prusa3d/Buddy-board-MINI-PCB/rev.1.0.0/shapes3D/W25Q64FVSSIG.stp

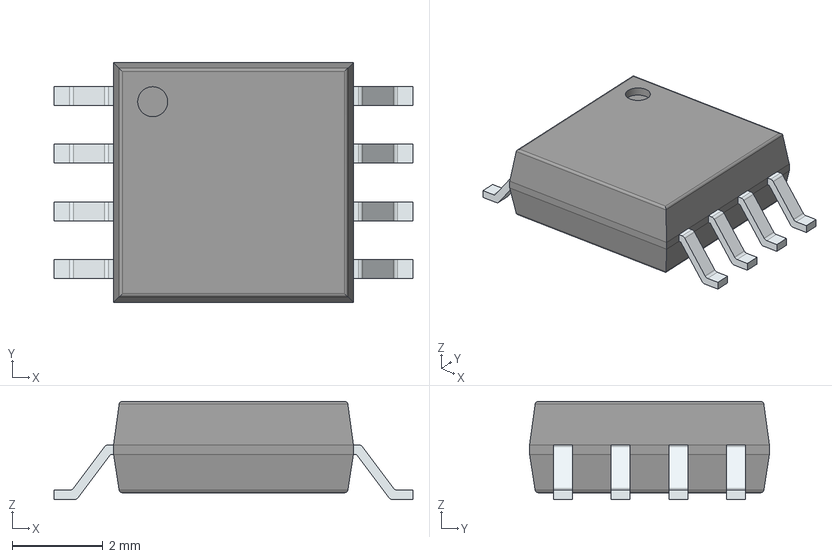
[picture p2: CAD file, 2019-12-11]
rev.1.0.0/shapes3D/W25Q64FVSSIG.stp
7.90 x 5.28 x 2.16 mm
PinsArrayLR
