prusa3d/Buddy-board-MINI-PCB/rev.1.0.0/shapes3D/DT1140-04LP.step

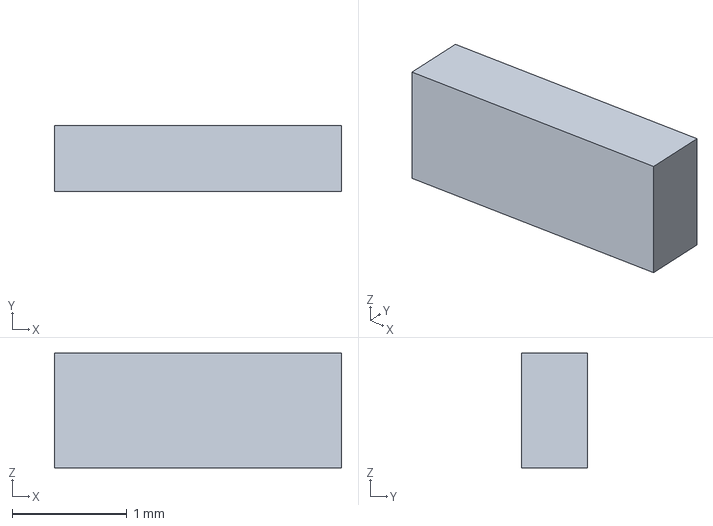
[picture p3: CAD file, 2019-12-11]
rev.1.0.0/shapes3D/DT1140-04LP.step
2.50 x 0.575 x 1.00 mm
