prusa3d/Buddy-board-MINI-PCB/rev.1.0.0/shapes3D/RJMG163118101NR.step

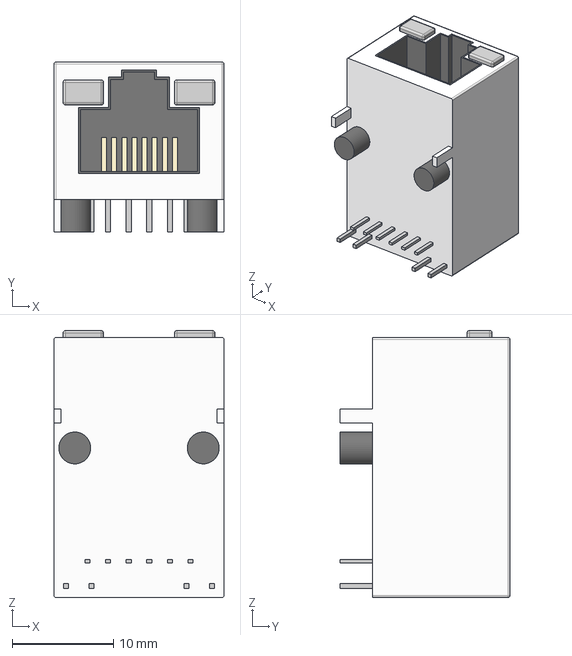
[picture p4: CAD file, 2019-12-11]
rev.1.0.0/shapes3D/RJMG163118101NR.step
16.8 x 16.8 x 26.4 mm
