prusa3d/Buddy-board-MINI-PCB/rev.1.0.0/shapes3D/Ethernet_HR911105A v1.step

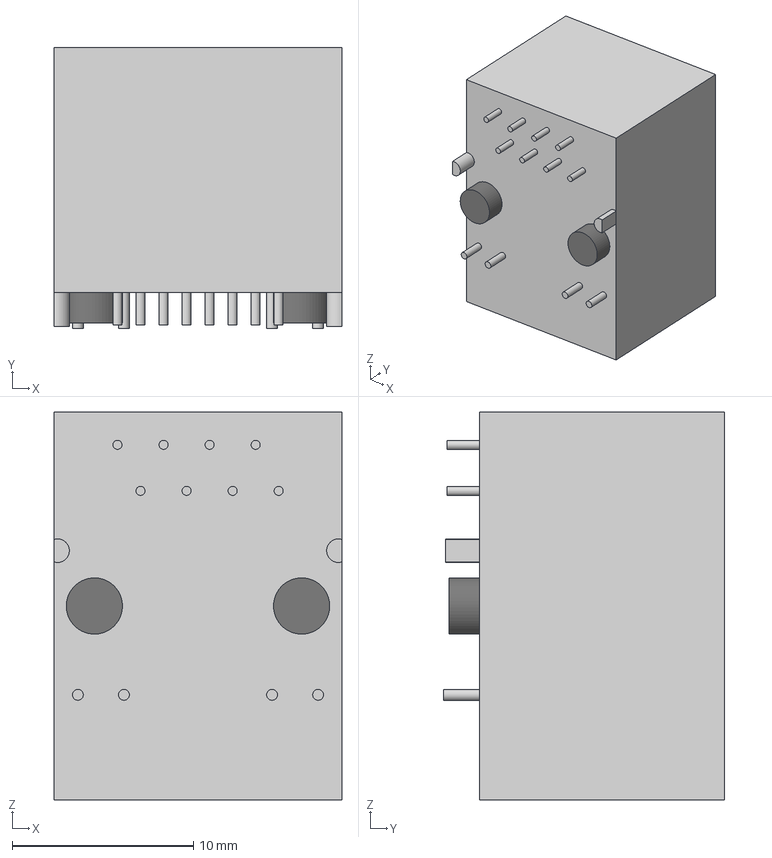
[picture p5: CAD file, 2019-12-11]
rev.1.0.0/shapes3D/Ethernet_HR911105A v1.step
15.9 x 15.5 x 21.4 mm
