prusa3d/Buddy-board-MINI-PCB/rev.1.0.0/shapes3D/559321010.stp

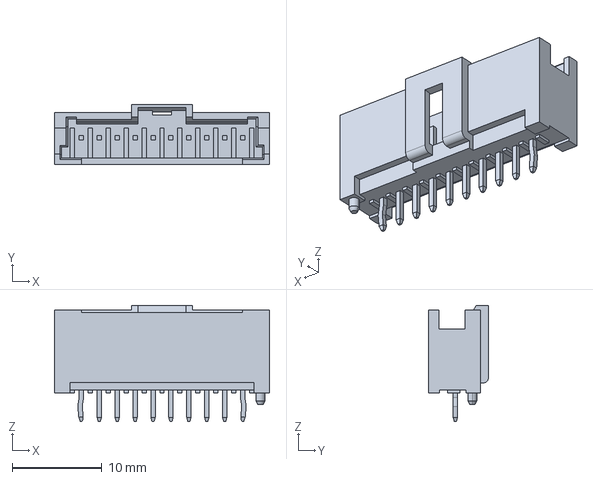
[picture p6: CAD file, 2019-12-11]
rev.1.0.0/shapes3D/559321010.stp
24.0 x 6.70 x 12.9 mm
