prusa3d/Buddy-board-MINI-PCB/rev.1.0.0/shapes3D/5031591200.stp

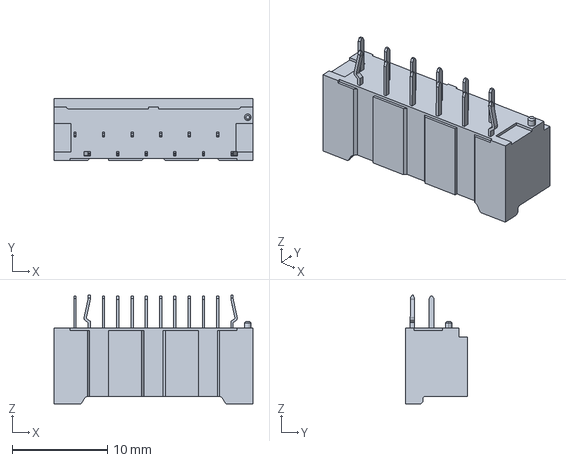
[picture p7: CAD file, 2019-12-11]
rev.1.0.0/shapes3D/5031591200.stp
20.9 x 6.55 x 11.4 mm
