prusa3d/Buddy-board-MINI-PCB/rev.1.0.0/shapes3D/7499010121A (rev1).stp

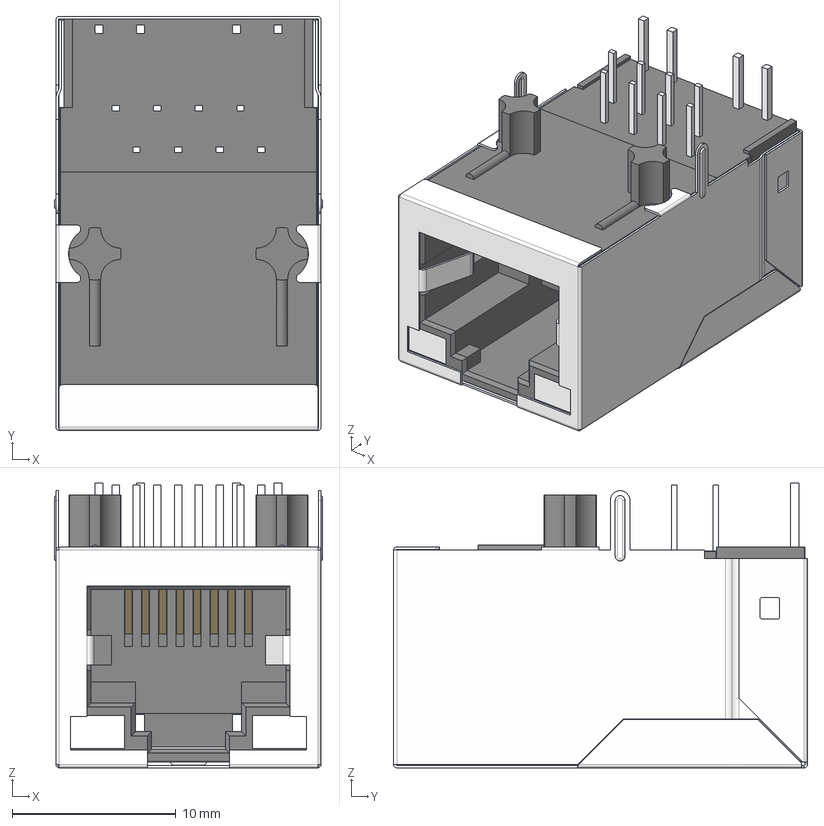
[picture p8: CAD file, 2019-12-11]
rev.1.0.0/shapes3D/7499010121A (rev1).stp
16.4 x 25.3 x 17.4 mm
Insulator
Insulator_2
Shielding
LED x 2
