prusa3d/Buddy-board-MINI-PCB/rev.1.0.0/shapes3D/673298020.stp

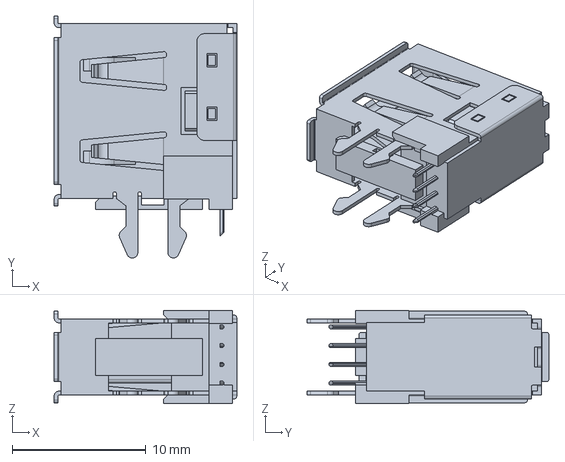
[picture p9: CAD file, 2019-12-11]
rev.1.0.0/shapes3D/673298020.stp
13.7 x 18.1 x 7.00 mm
