prusa3d/Buddy-board-MINI-PCB/rev.1.0.0/shapes3D/934635206.stp

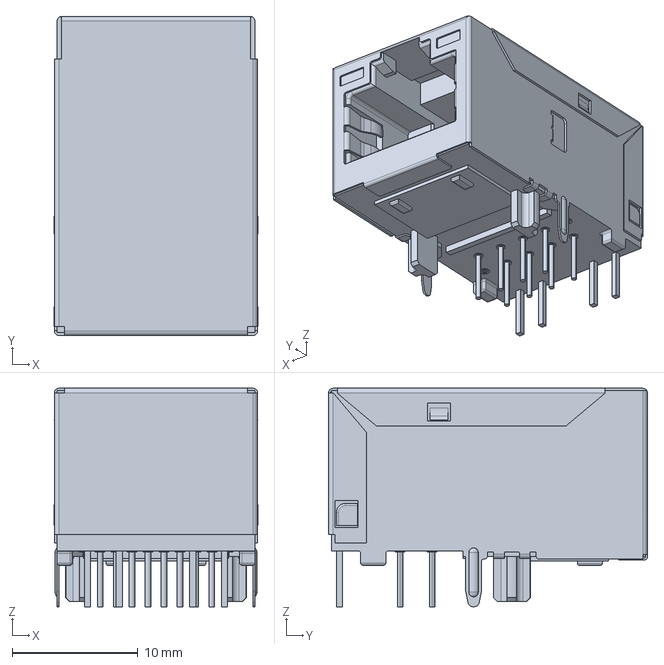
[picture p10: CAD file, 2019-12-11]
rev.1.0.0/shapes3D/934635206.stp
16.2 x 25.4 x 17.4 mm
