prusa3d/Buddy-board-MINI-PCB/(list of files, cad)

Other CAD files:
rev.1.0.0/shapes3D/673298000.stp
