prusa3d/Buddy-board-MINI-PCB/(threads)

Thread 1 (2019-12-11):

Wrong link to Interactive BOM

dronecz, 2019-12-11:
Right one is: http://htmlpreview.github.io/?https://github.com/prusa3d/Buddy-board-MINI-PCB/blob/master/rev.1.0.0/ibom.html

jarodan, 2019-12-11:
Link has been fixed. Thank you

Closed 2019-12-11.

Thread 2 (2019-12-14):

Bootloader, Firmware and Compiling instructions

CacikeOtoao, 2019-12-14:
Could you point me as to where the Bootloader, Firmware and compiling instructions are for this board. Is not in the main branch of Prusa Firmwares.

3d-gussner, 2019-12-20:
Checkout https://github.com/prusa3d/Marlin/tree/buddy not sure that is all. Just found it.

CacikeOtoao, 2019-12-23:
Thanks@3d-gussner! I'm building my Buddy board from source files and still have a doubt regarding the Bootloader. Would I be able to just flash the Firmware .bbf file to the built board and not need to flash the bootloader before hand?

Thread 4 (2023-02-28):

Fan schematic appears to be wrong

your-friend-alice, 2023-02-28:
The schematic shows that the fans are controlled by low-side switching (Pin 2 always connected to +5V, Pin 1 connected to GND through an N-channel MOSFET), but probing my board I can clearly tell that the fans are being high-side switched; pin 1 remains grounded continuously while pin 2 changes state based on M106 commands. What's up with this? Is there a newer unpublished revision of the Buddy board?

Thread 5 (2023-05-04):

v1.0.5 board schematic and kicad?

andypiper, 2023-05-04:
There are revisions of the Buddy board for the MINI+ beyond v1.0.0 - are these also available in an Open Source format?
