prusa3d/Buddy-board-MINI-PCB/rev.1.0.0/BUDDY_v1.0.0.pdf

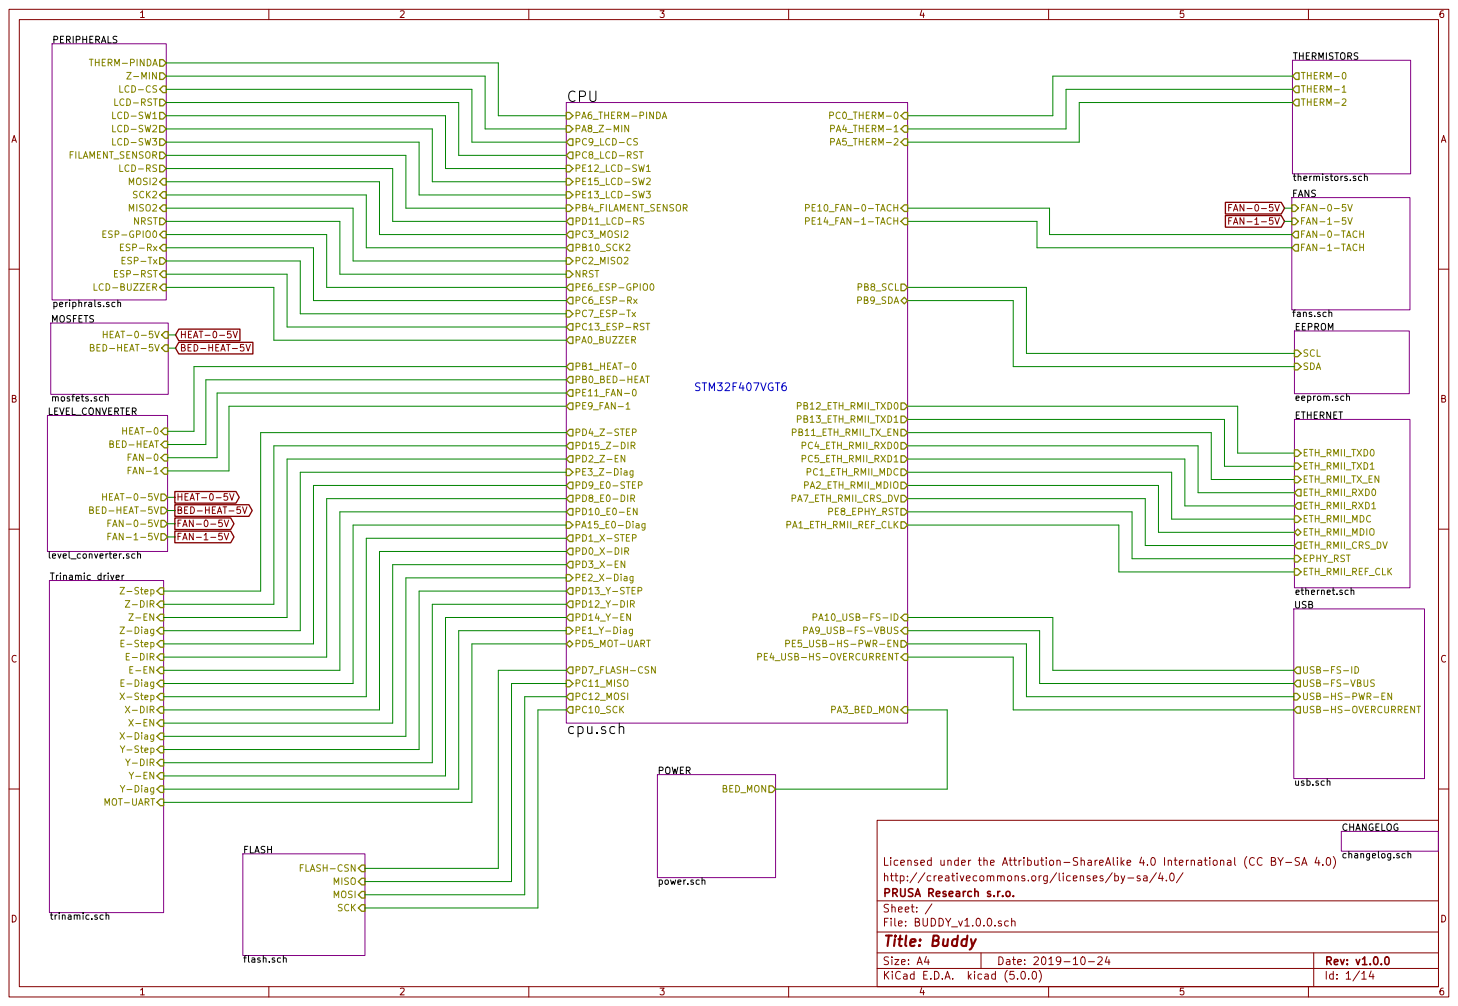
[picture p11: page 1]

periphrals.sch THERM-PINDA

Z-MIN
LCD-CS
LCD-RST
LCD-SW1
LCD-SW2
LCD-SW3
SCK2 MOSI2 NRST MISO2 ESP-Rx ESP-Tx ESP-RST ESP-GPIO0

thermistors.sch THERM-0 THERM-1 THERM-2 BED-HEAT-5V HEAT-0-5V HEAT-0-5V

USB-HS-OVERCURRENT CPU
PE11_FAN-0 PE9_FAN-1 PA8_Z-MIN
PC9_LCD-CS
PE12_LCD-SW1 PD11_LCD-RS
PC6_ESP-Rx PC7_ESP-Tx PE6_ESP-GPIO0 PD1_X-STEP
PB0_BED-HEAT PB1_HEAT-0 PD5_MOT-UART PD15_Z-DIR

eeprom.sch SCL SDA

LEVEL_CONVERTER
level_converter.schHEAT-0 FAN-0 FAN-1 BED-HEAT HEAT-0-5V

Trinamic driver
Z-Diag MOT-UART E-Step E-DIR

PE4_USB-HS-OVERCURRENT PE5_USB-HS-PWR-EN

usb.sch USB-FS-ID
USB-FS-VBUS USB-HS-PWR-EN

Licensed under the Attribution-ShareAlike 4.0 International (CC BY-SA 4.0)
File: BUDDY_v1.0.0.sch Sheet: / PRUSA Research s.r.o. http://creativecommons.org/licenses/by-sa/4.0/

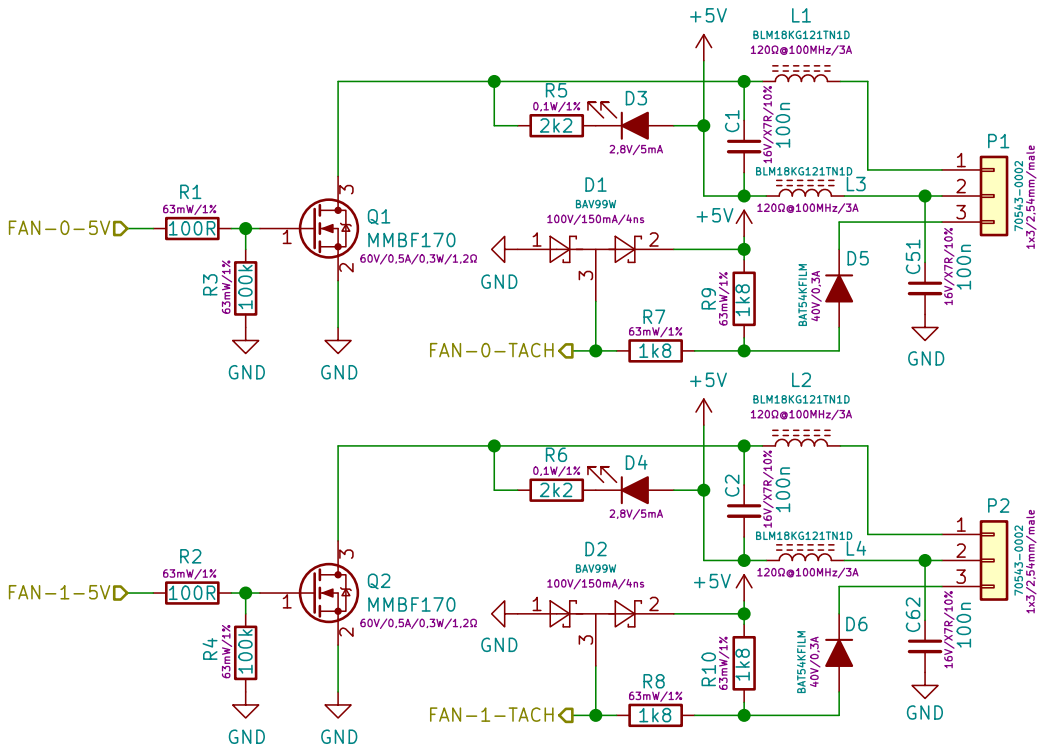
[picture p12: page 2]

Licensed under the Attribution-ShareAlike 4.0 International (CC BY-SA 4.0)
File: fans.sch Sheet: /FANS/ PRUSA Research s.r.o. http://creativecommons.org/licenses/by-sa/4.0/

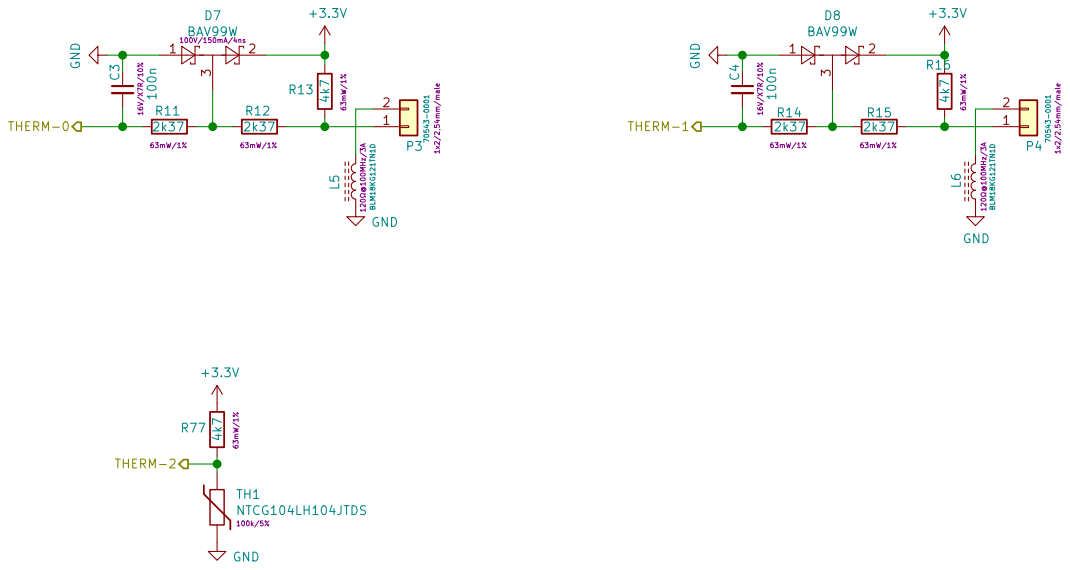
[picture p13: page 3]

Licensed under the Attribution-ShareAlike 4.0 International (CC BY-SA 4.0)
File: thermistors.sch Sheet: /THERMISTORS/ PRUSA Research s.r.o. http://creativecommons.org/licenses/by-sa/4.0/

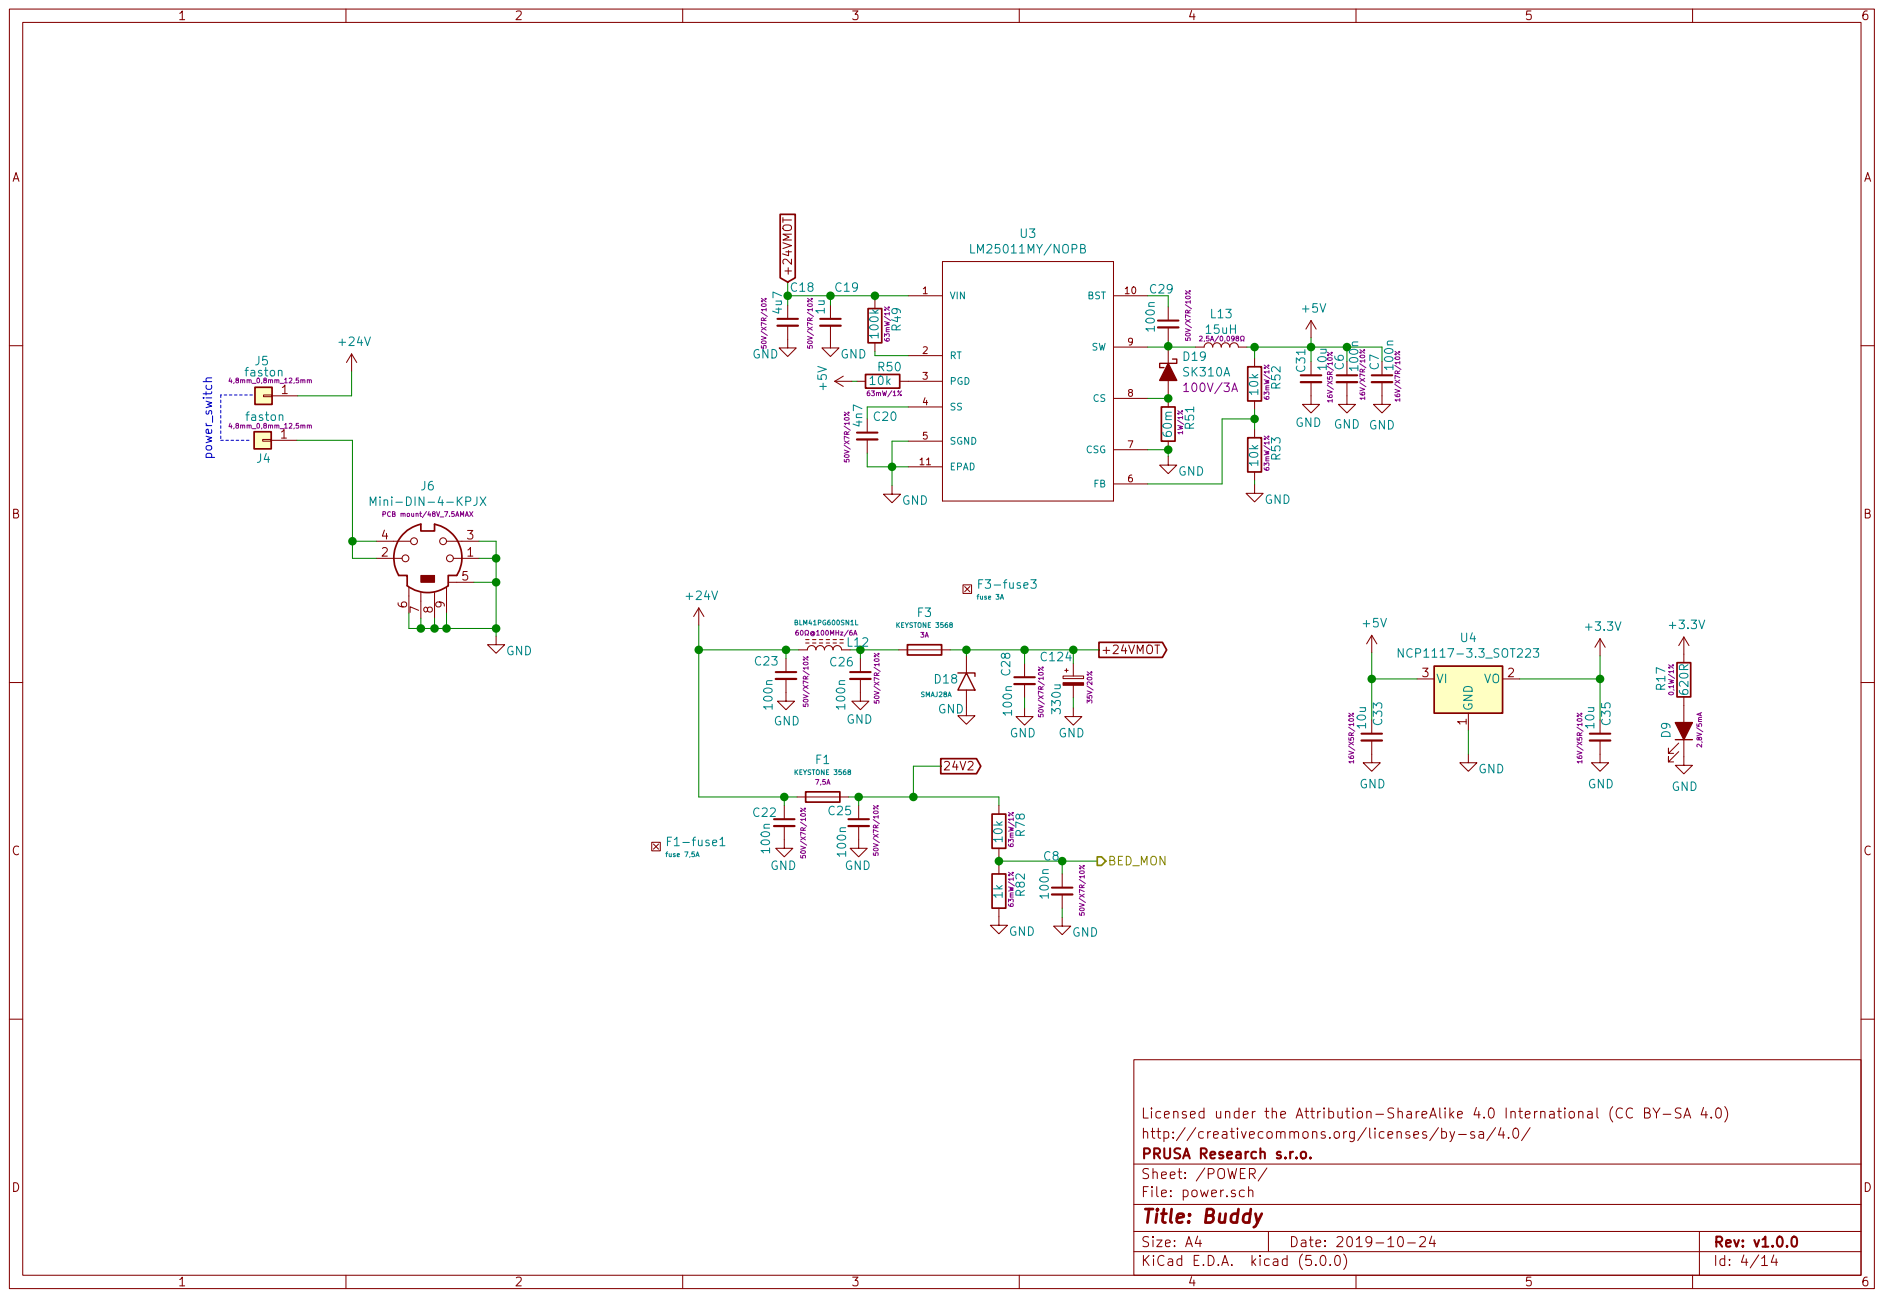
[picture p14: page 4]

Licensed under the Attribution-ShareAlike 4.0 International (CC BY-SA 4.0)
File: power.sch Sheet: /POWER/ PRUSA Research s.r.o. http://creativecommons.org/licenses/by-sa/4.0/

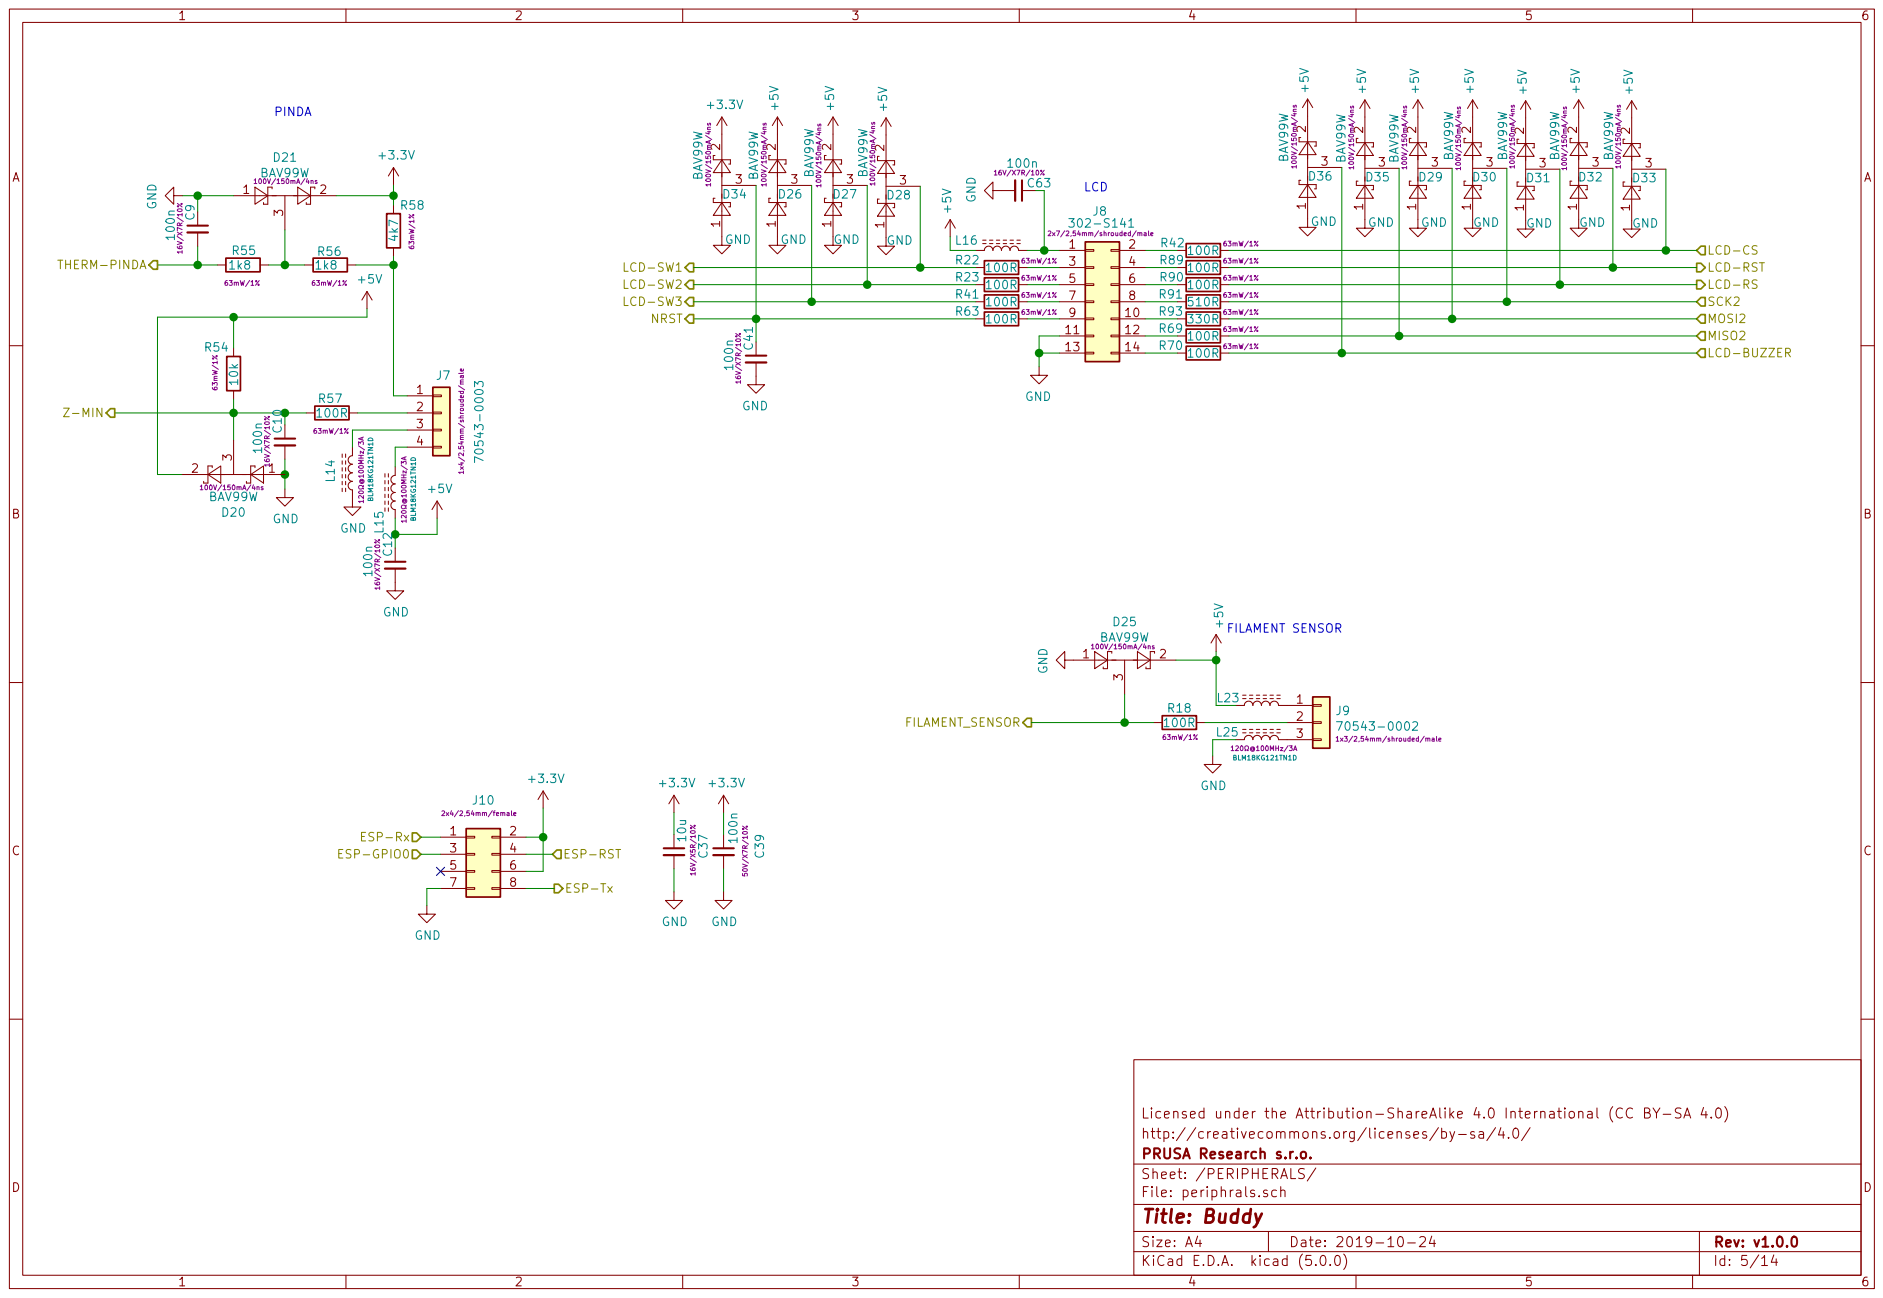
[picture p15: page 5]

Licensed under the Attribution-ShareAlike 4.0 International (CC BY-SA 4.0)
File: periphrals.sch Sheet: /PERIPHERALS/ PRUSA Research s.r.o. http://creativecommons.org/licenses/by-sa/4.0/

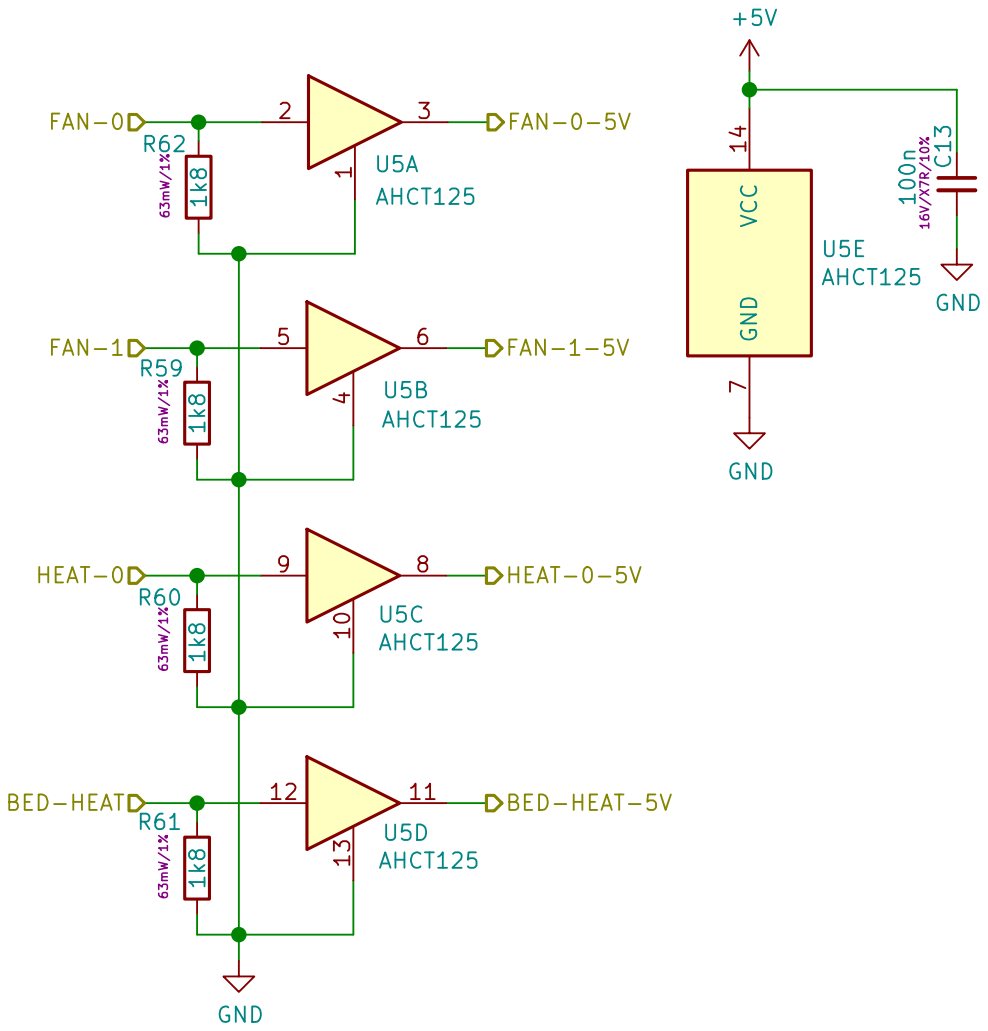
[picture p16: page 6]

Licensed under the Attribution-ShareAlike 4.0 International (CC BY-SA 4.0)
Sheet: /LEVEL_CONVERTER/ PRUSA Research s.r.o. http://creativecommons.org/licenses/by-sa/4.0/

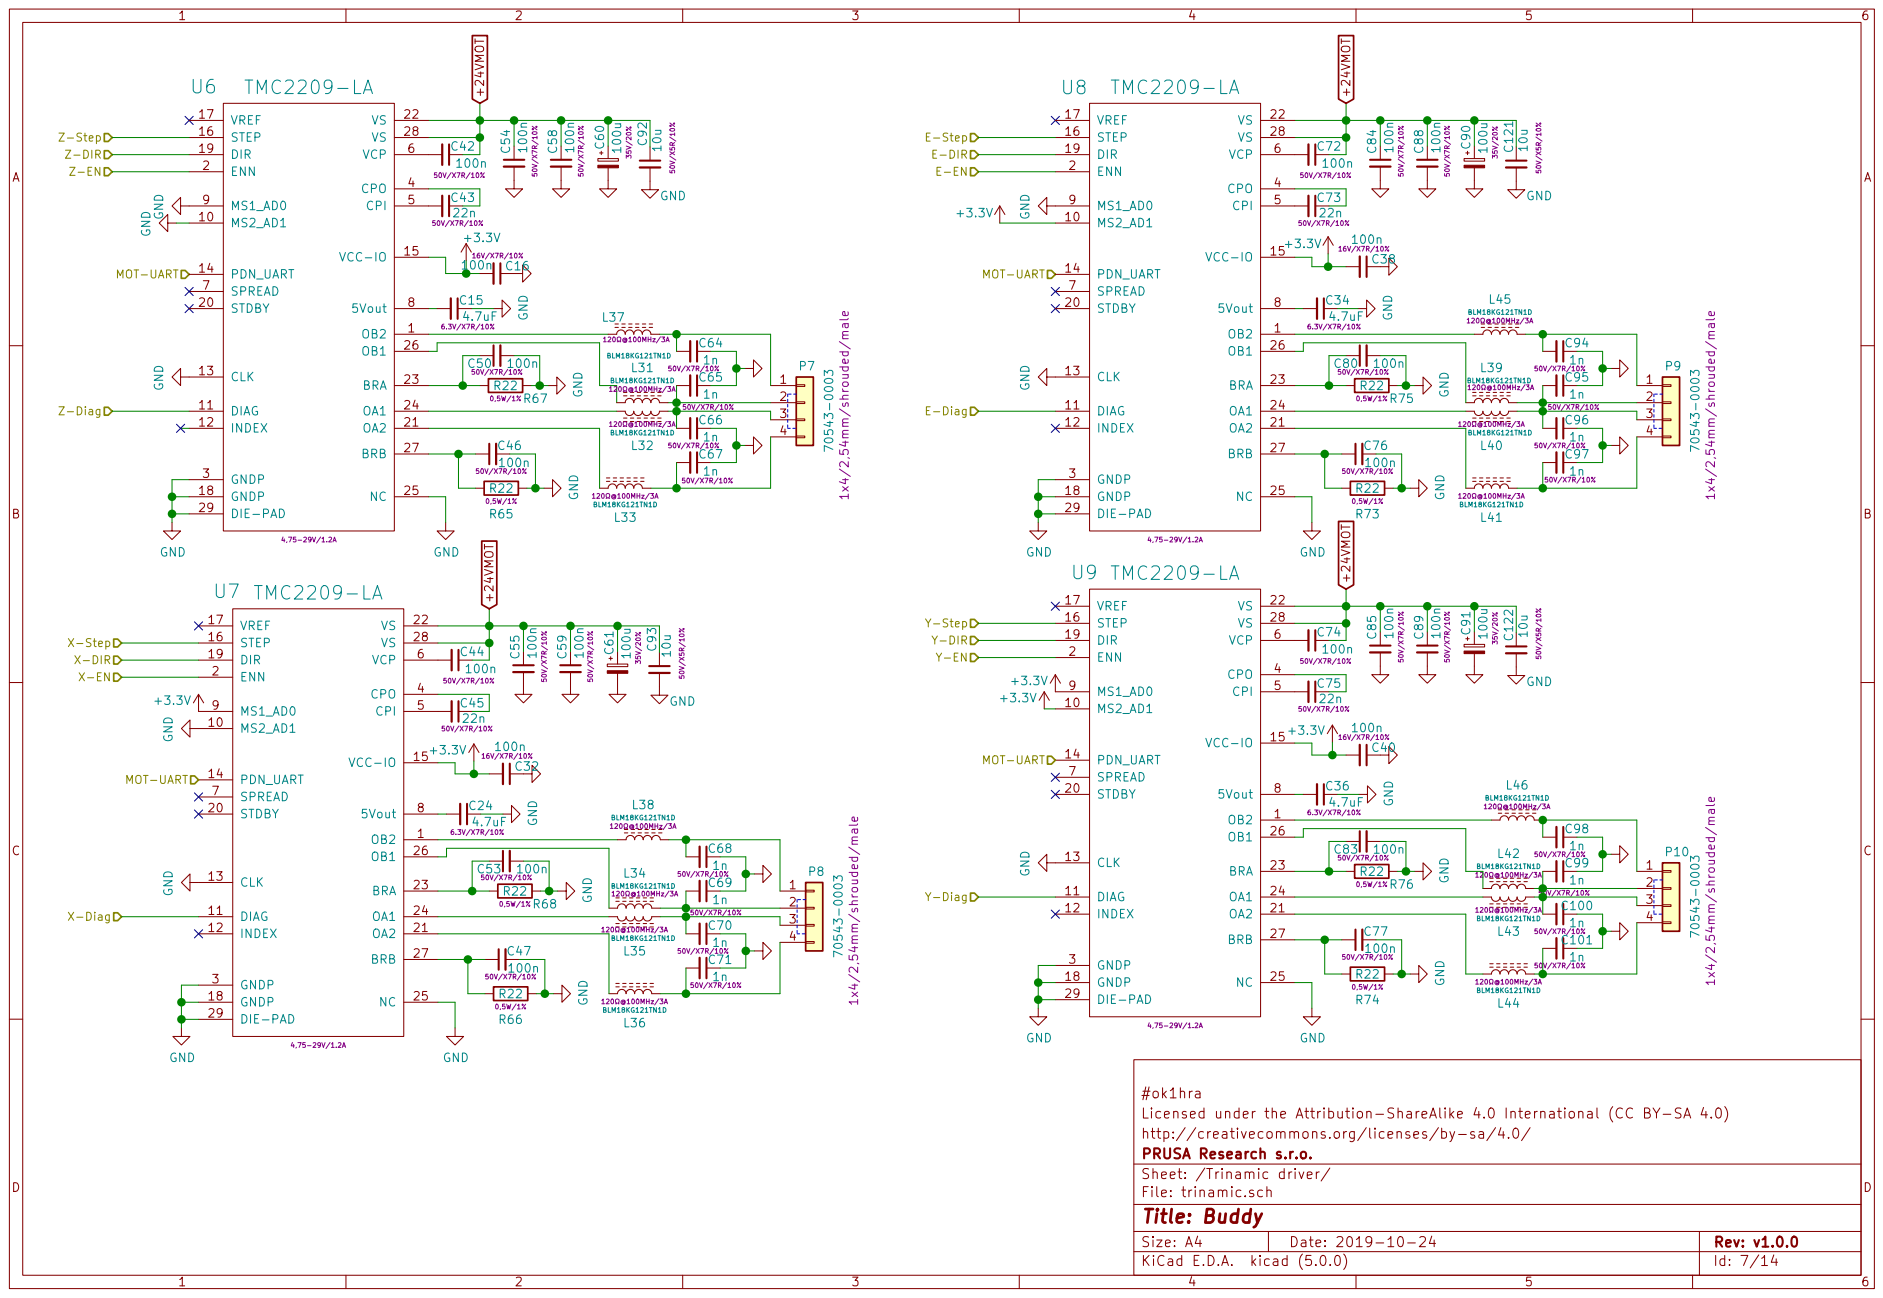
[picture p17: page 7]

Licensed under the Attribution-ShareAlike 4.0 International (CC BY-SA 4.0) #ok1hra GND GND GND

File: trinamic.sch Sheet: /Trinamic driver/ PRUSA Research s.r.o. http://creativecommons.org/licenses/by-sa/4.0/

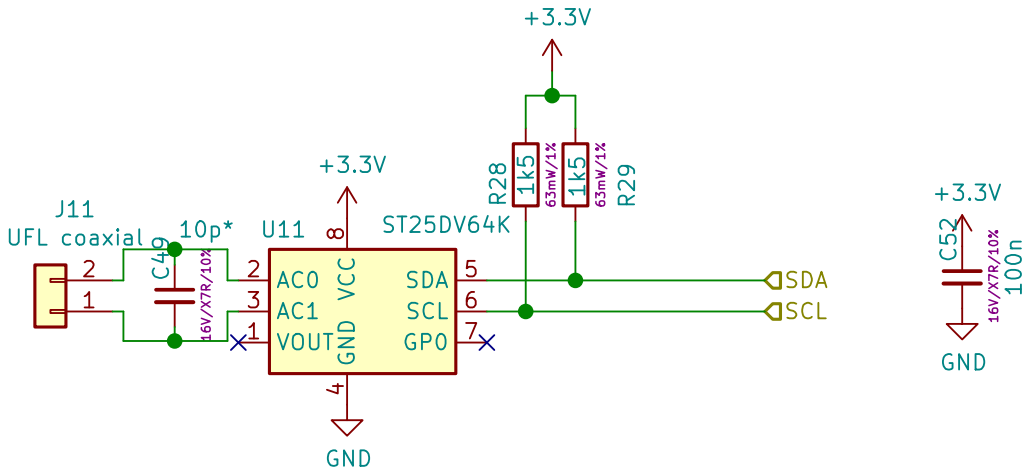
[picture p18: page 8]

Licensed under the Attribution-ShareAlike 4.0 International (CC BY-SA 4.0)
File: eeprom.sch Sheet: /EEPROM/ PRUSA Research s.r.o. http://creativecommons.org/licenses/by-sa/4.0/

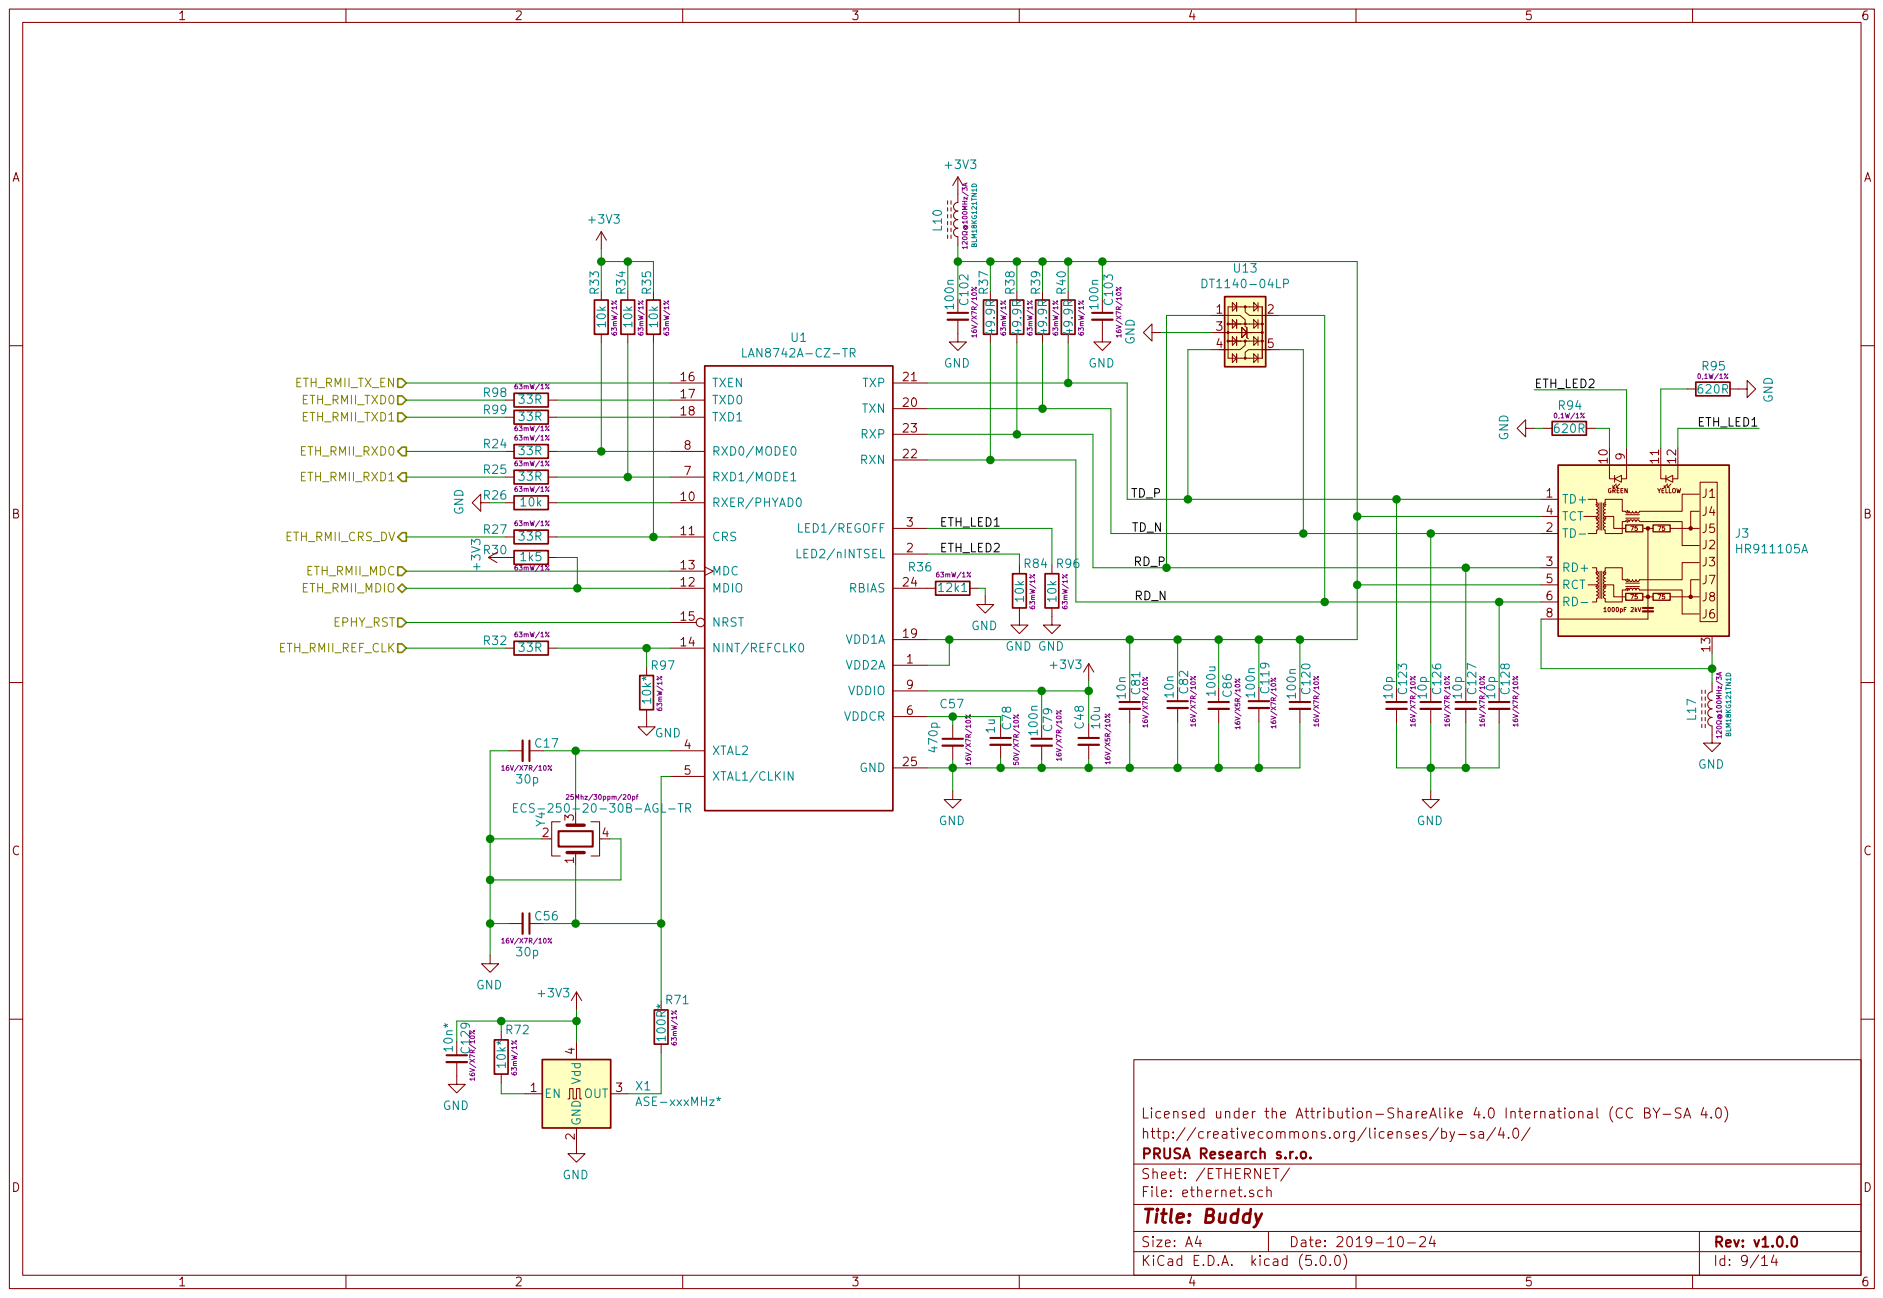
[picture p19: page 9]

Licensed under the Attribution-ShareAlike 4.0 International (CC BY-SA 4.0)
File: ethernet.sch Sheet: /ETHERNET/ PRUSA Research s.r.o. http://creativecommons.org/licenses/by-sa/4.0/

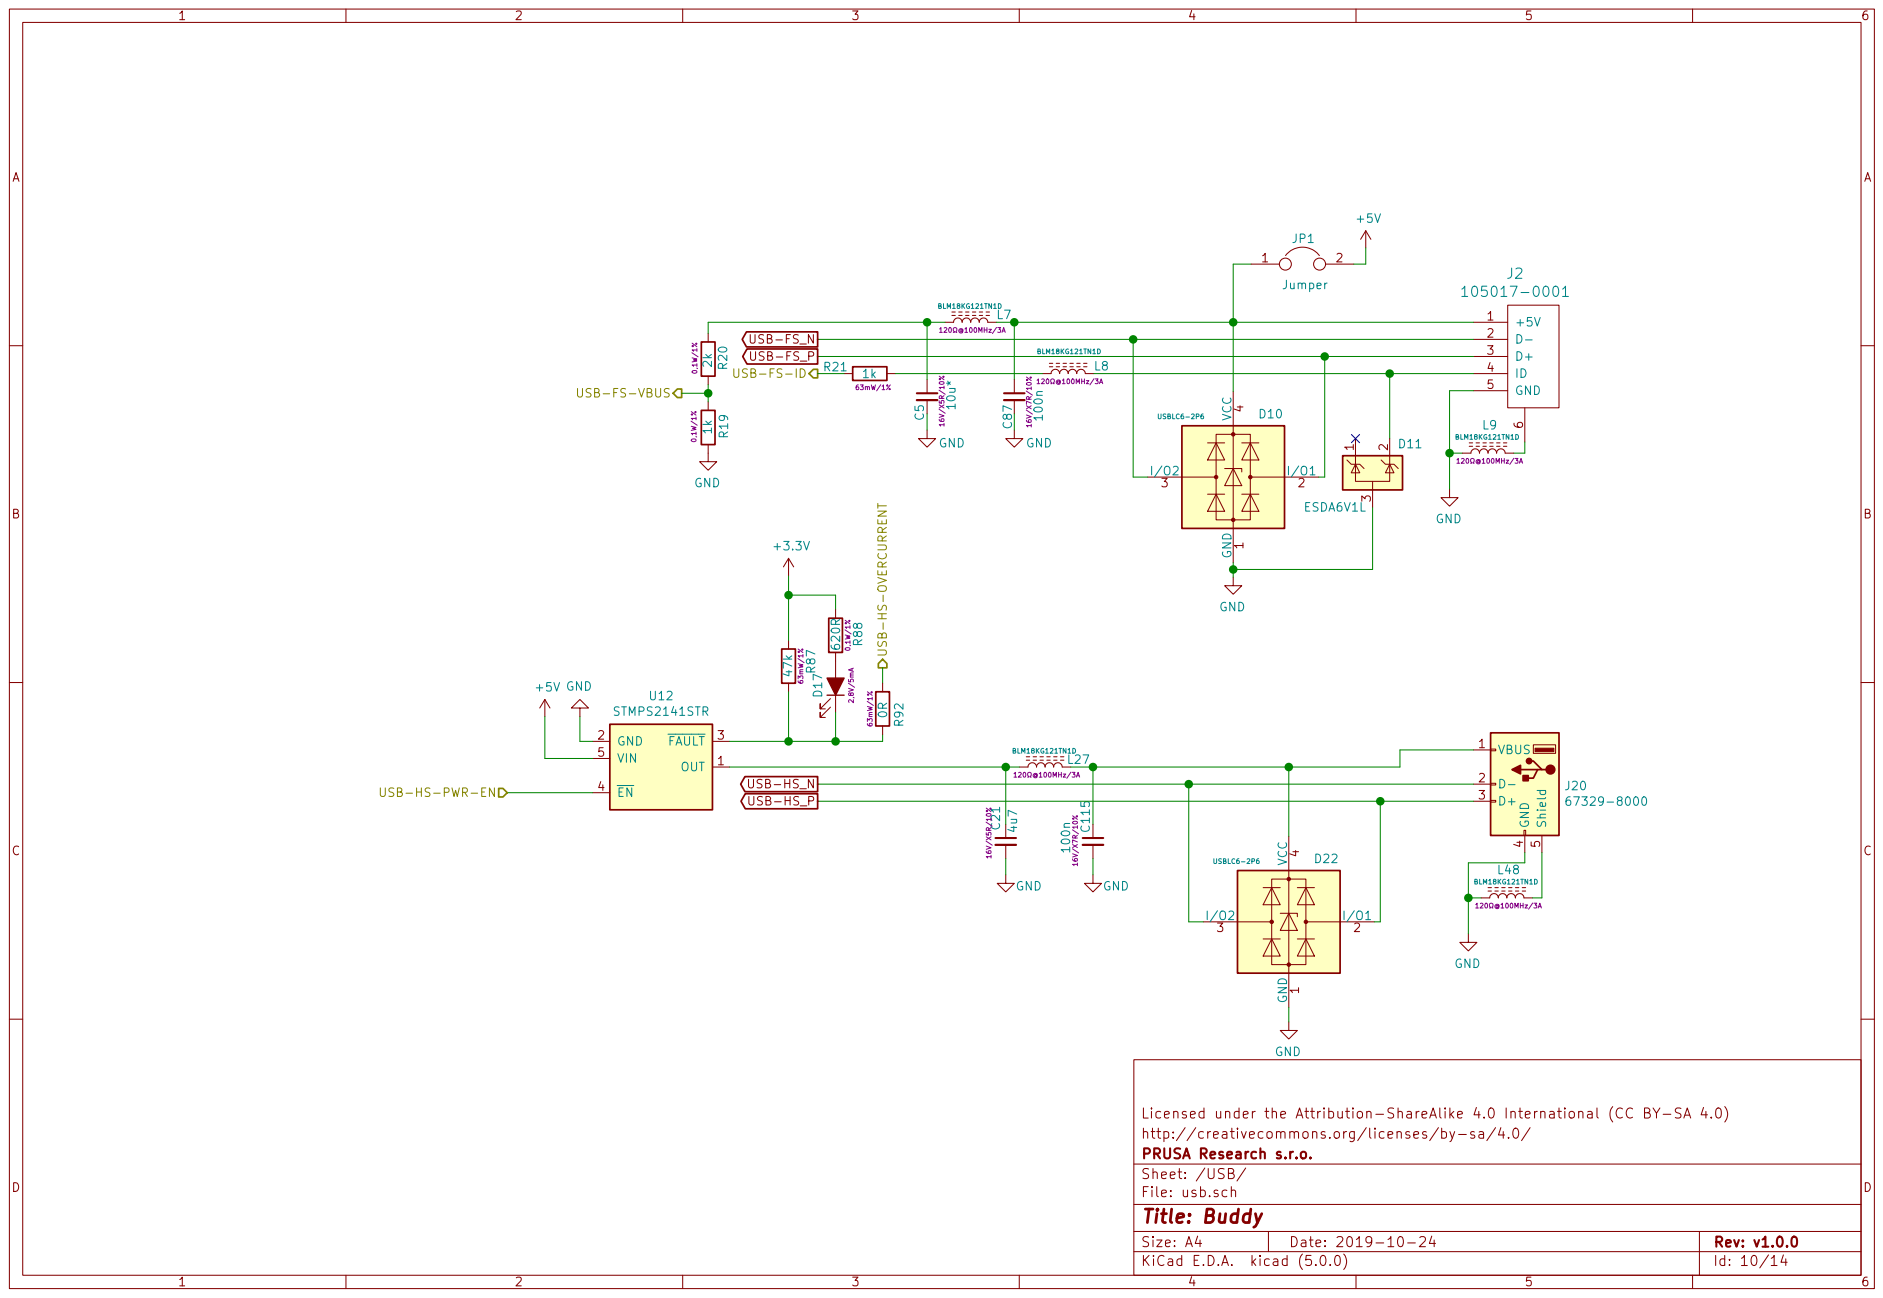
[picture p20: page 10]

Licensed under the Attribution-ShareAlike 4.0 International (CC BY-SA 4.0)
File: usb.sch Sheet: /USB/ PRUSA Research s.r.o. http://creativecommons.org/licenses/by-sa/4.0/

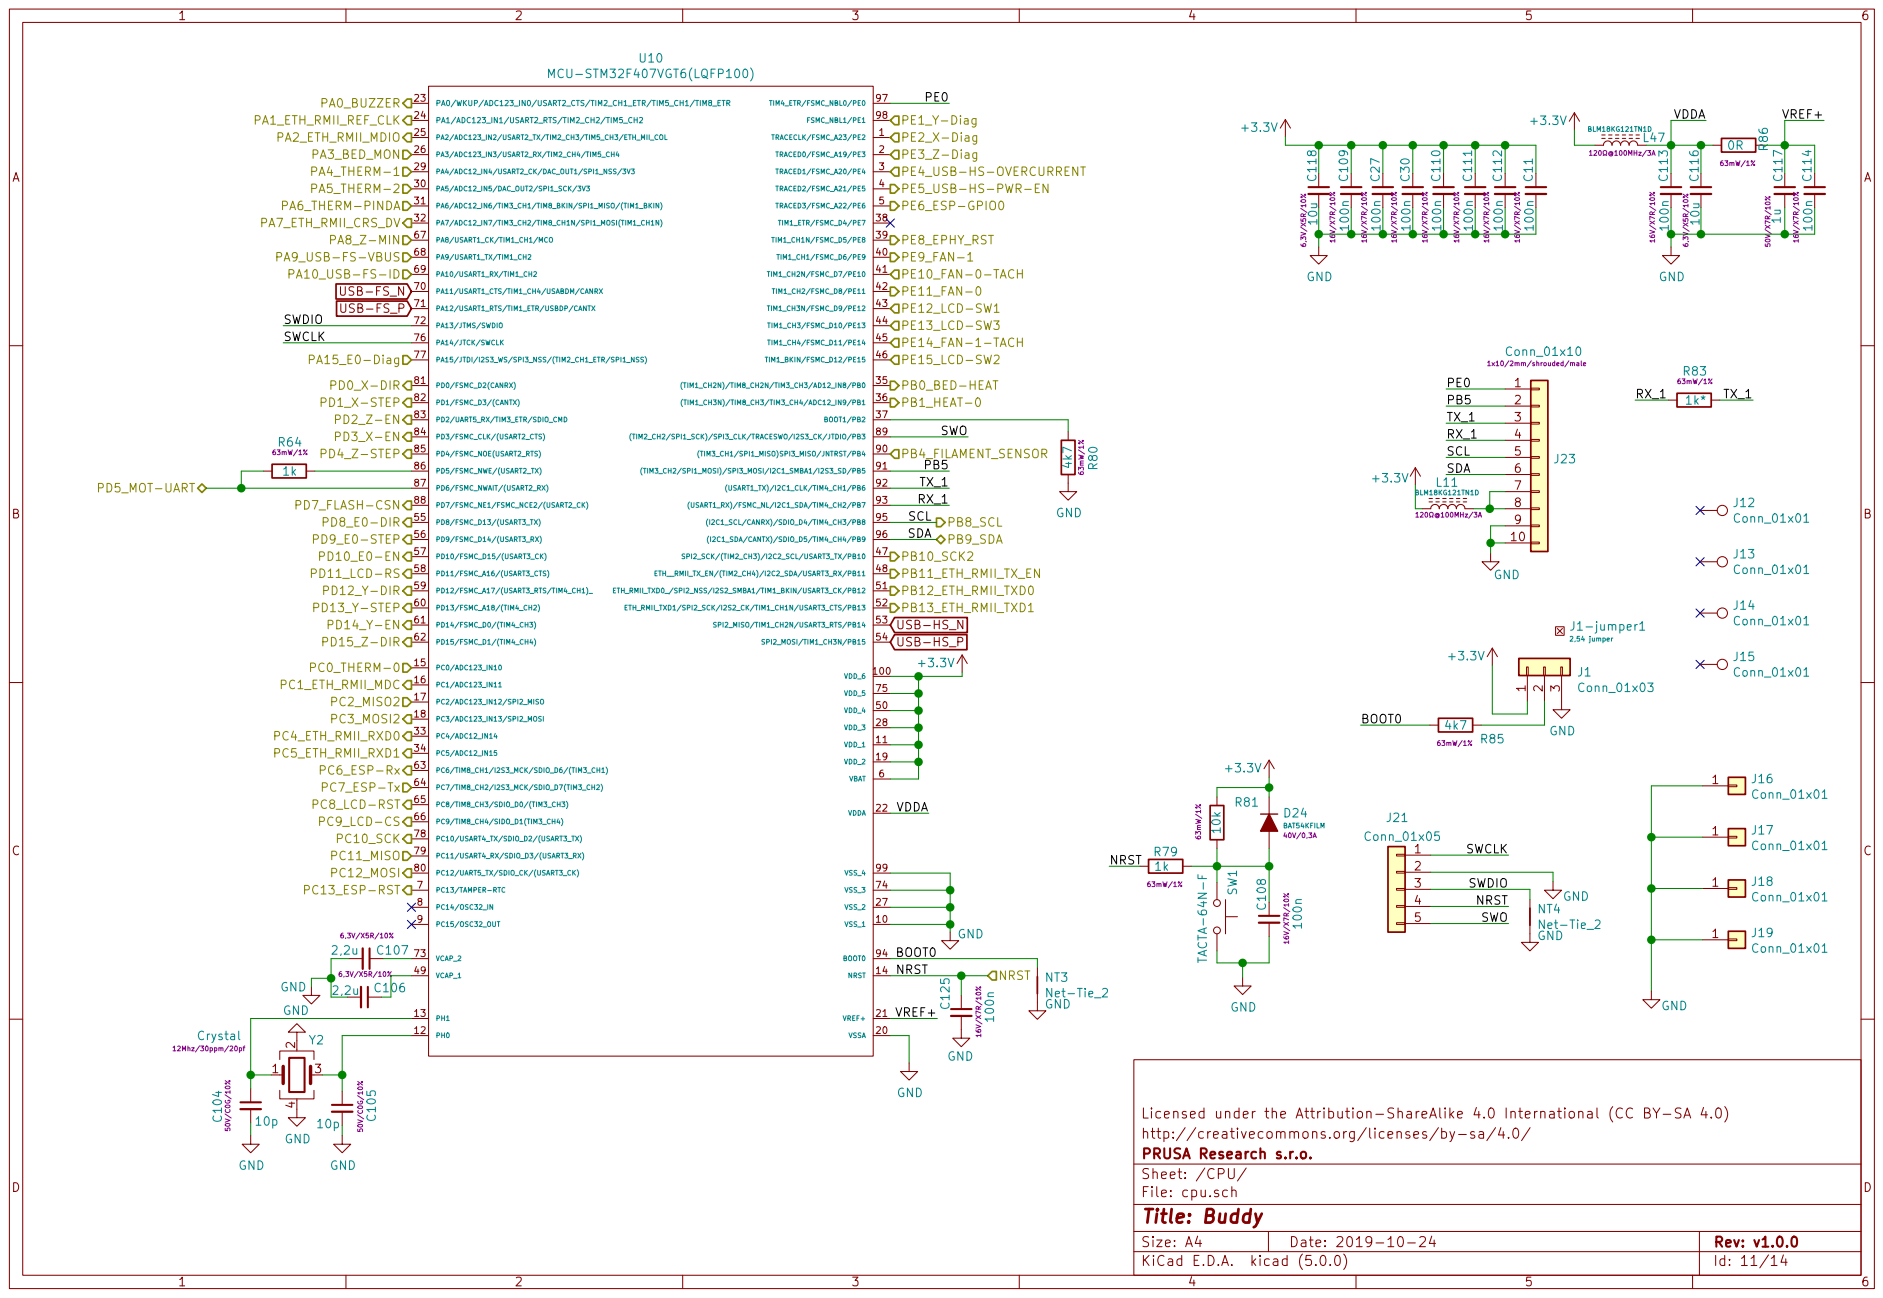
[picture p21: page 11]

J15 Conn_01x01 PE4_USB-HS-OVERCURRENT PE5_USB-HS-PWR-EN

Licensed under the Attribution-ShareAlike 4.0 International (CC BY-SA 4.0) 1

File: cpu.sch Sheet: /CPU/ PRUSA Research s.r.o. http://creativecommons.org/licenses/by-sa/4.0/

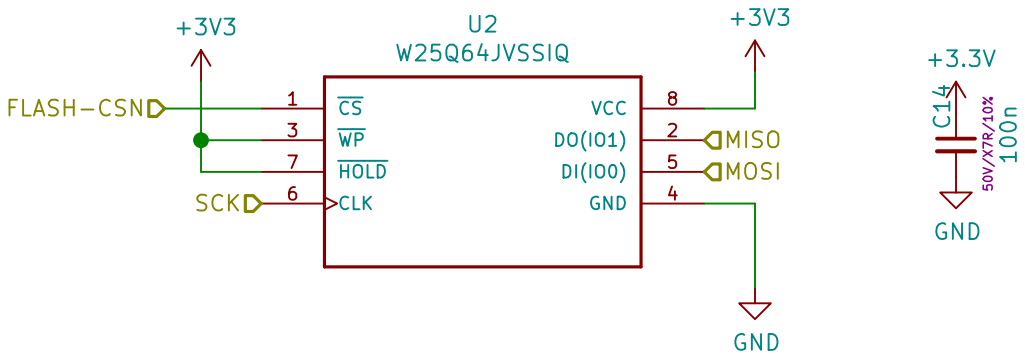
[picture p22: page 12]

Licensed under the Attribution-ShareAlike 4.0 International (CC BY-SA 4.0)
File: flash.sch Sheet: /FLASH/ PRUSA Research s.r.o. http://creativecommons.org/licenses/by-sa/4.0/

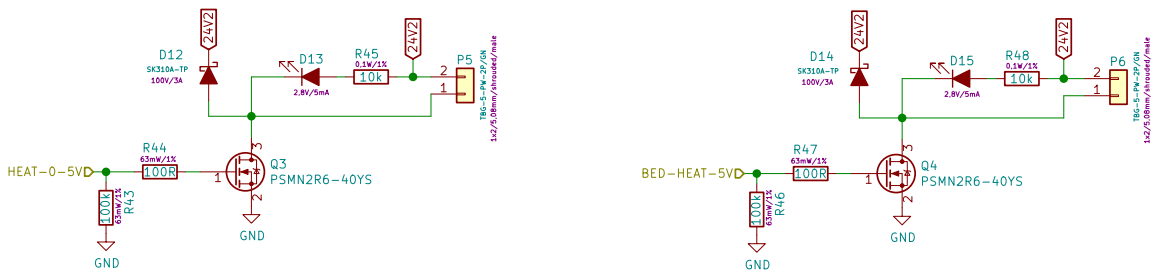
[picture p23: page 13]

2 P5 TBG-5-PW-2P/GN 1x2/5,08mm/shrouded/male D12

Licensed under the Attribution-ShareAlike 4.0 International (CC BY-SA 4.0)
File: mosfets.sch Sheet: /MOSFETS/ PRUSA Research s.r.o. http://creativecommons.org/licenses/by-sa/4.0/

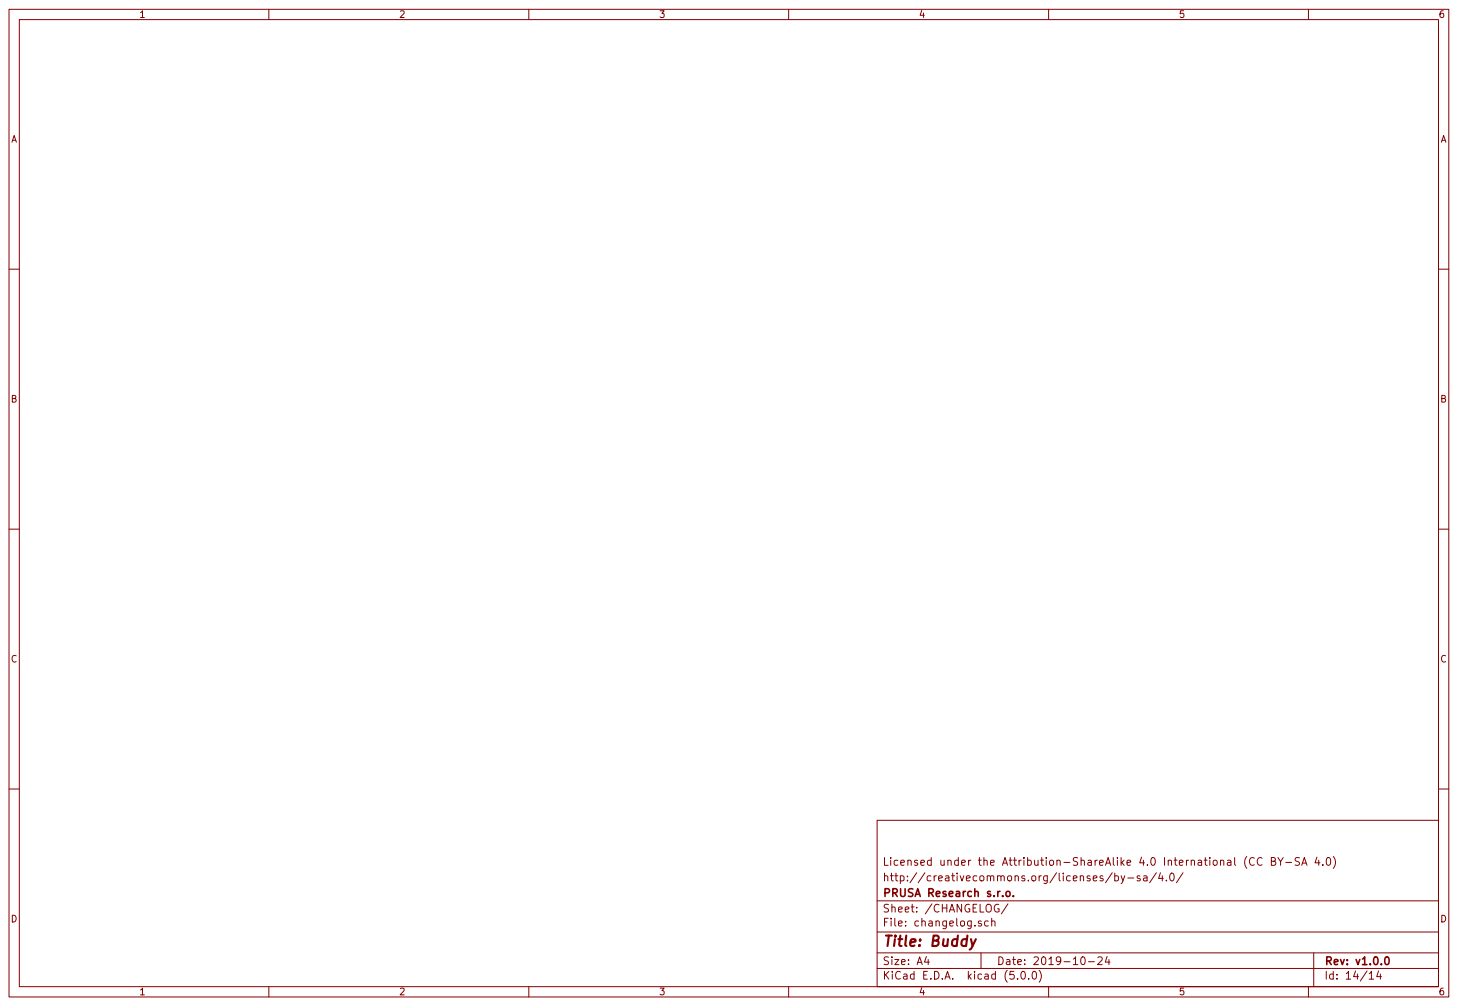
[picture p24: page 14]

Licensed under the Attribution-ShareAlike 4.0 International (CC BY-SA 4.0)
File: changelog.sch Sheet: /CHANGELOG/ PRUSA Research s.r.o. http://creativecommons.org/licenses/by-sa/4.0/
