prusa3d/Buddy-board-MINI-PCB/rev.1.0.0/BUDDY_v1.0.0.kicad_pcb

## KiCad design rev.1.0.0/BUDDY_v1.0.0.kicad_pcb (2019-12-11)

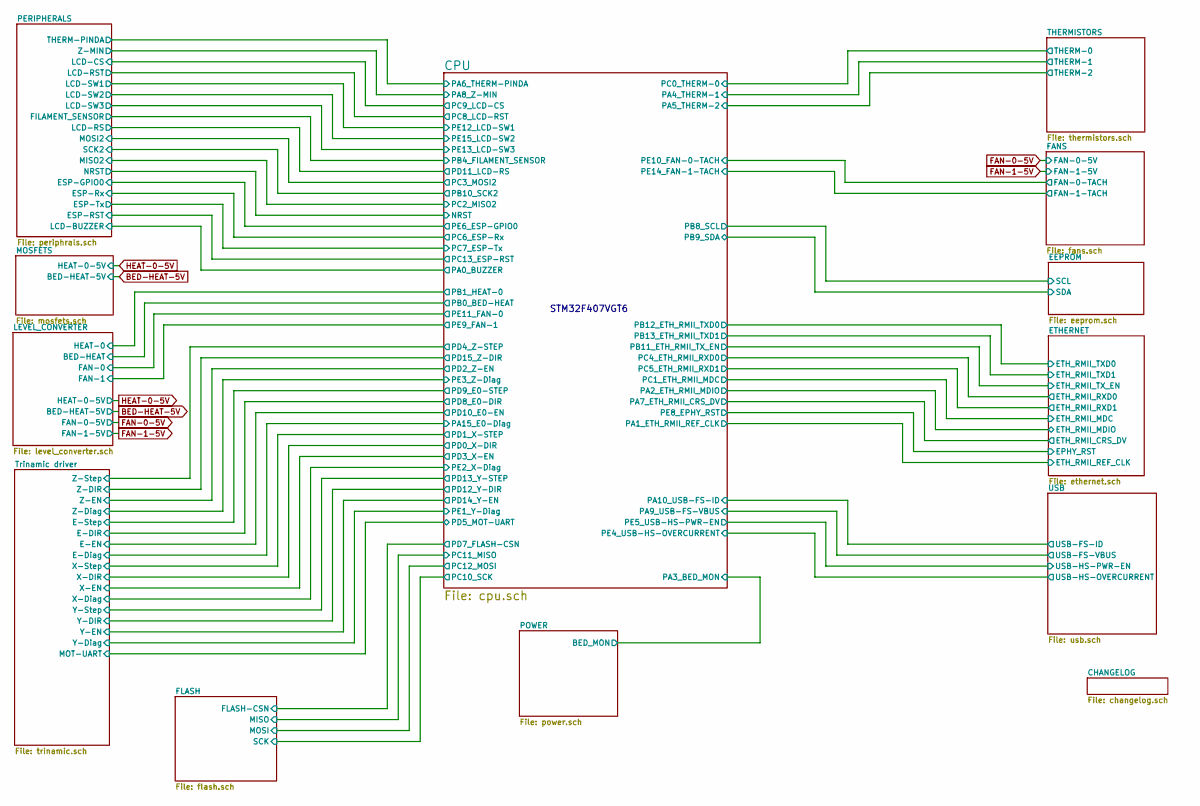
[picture p25: schematic BUDDY_v1.0.0.sch, Buddy]

Notes on the sheet:
STM32F407VGT6

Schematic: fans.sch, Buddy

Parts:
C1, C2, C51, C62: 100n; C_0402_1005Metric
D1, D2: BAV99W; SOT-323_SC-70
D3, D4: GRN; LED_0603
D5, D6: BAT54KFILM; D_SOD-523
L1, L2, L3, L4: BLM18KG121TN1D; R_0603_1608Metric
P1, P2: 70543-0002; Pin_1x03-XL
Q1, Q2: MMBF170; SOT-23
R1, R2: 100R; R_0402_1005Metric
R3, R4: 100k; R_0402_1005Metric
R5, R6: 2k2; R_0603_1608Metric
R7, R8, R9, R10: 1k8; R_0402_1005Metric

Connections:
+5V: C1.2, C2.2, D1.2, D2.2, D3.2, D4.2, L3.1, L4.1, R9.2, R10.2; also elsewhere on the board
/FANS/FAN-0-TACH: D1.3, R7.1; also elsewhere on the board
/FANS/FAN-1-TACH: D2.3, R8.1; also elsewhere on the board
FAN-0-5V: R1.1; also elsewhere on the board
FAN-1-5V: R2.1; also elsewhere on the board
GND: C51.2, C62.2, D1.1, D2.1, Q1.2 (S), Q2.2 (S), R3.2, R4.2; also elsewhere on the board
unnamed: C1.1, L1.1, Q1.3 (D), R5.1
unnamed: C2.1, L2.1, Q2.3 (D), R6.1
unnamed: C51.1, L3.2, P1.2
unnamed: C62.1, L4.2, P2.2
unnamed: D3.1, R5.2
unnamed: D4.1, R6.2
unnamed: D5.1, P1.3
unnamed: D5.2, R7.2, R9.1
unnamed: D6.1, P2.3
unnamed: D6.2, R8.2, R10.1
unnamed: L1.2, P1.1
unnamed: L2.2, P2.1
unnamed: Q1.1 (G), R1.2, R3.1
unnamed: Q2.1 (G), R2.2, R4.1

Schematic: thermistors.sch, Buddy

Parts:
C3, C4: 100n; C_0402_1005Metric
D7, D8: BAV99W; SOT-323_SC-70
L5, L6: BLM18KG121TN1D; R_0603_1608Metric
P3, P4: 70543-0001; Pin_1x02-XL
R11, R12, R14, R15: 2k37; R_0402_1005Metric
R13, R16, R77: 4k7; R_0402_1005Metric
TH1: NTCG104LH104JTDS; R_0402_1005Metric

Connections:
+3V3: D7.2, D8.2, R13.1, R16.1, R77.1; also elsewhere on the board
/CPU/PA4_THERM-1: C4.2, R14.2; also elsewhere on the board
/CPU/PA5_THERM-2: R77.2, TH1.1; also elsewhere on the board
/CPU/PC0_THERM-0: C3.2, R11.2; also elsewhere on the board
GND: C3.1, C4.1, D7.1, D8.1, L5.1, L6.1, TH1.2; also elsewhere on the board
unnamed: D7.3, R11.1, R12.2
unnamed: D8.3, R14.1, R15.2
unnamed: L5.2, P3.2
unnamed: L6.2, P4.2
unnamed: P3.1, R12.1, R13.2
unnamed: P4.1, R15.1, R16.2

Schematic: power.sch, Buddy

Parts:
C6, C7: 100n; C_0402_1005Metric
C8, C22, C23, C25, C26, C28, C29: 100n; C_0603_1608Metric
C18: 4u7; C_1206_3216Metric
C19: 1u; C_0603_1608Metric
C20: 4n7; C_0402_1005Metric
C31, C33, C35: 10u; C_0805_2012Metric
C124: 330u; CP_Elec_8x10.5
D9: GRN; LED_0603
D18: SMAJ28A; D_SMA
D19: SK310A; DO-214AC
F1, F3: KEYSTONE 3568; Fuse-Keystone-3557-2
F1-fuse1: fuse 7,5A; MEC
F3-fuse3: fuse 3A; MEC
J4, J5: faston; faston-hole-m
J6: Mini-DIN-4-KPJX; KPJX-4S
L12: BLM41PG600SN1L; R_1806_4516Metric
L13: 15uH; VLS6045EX
R17: 620R; R_0603_1608Metric
R49: 100k; R_0402_1005Metric
R50, R52, R53, R78: 10k; R_0402_1005Metric
R51: 60m; R_2512_6332Metric
R82: 1k; R_0402_1005Metric
U3: LM25011MY/NOPB; SOP50P490X110-11N
U4: NCP1117-3.3_SOT223; SOT-223-3_TabPin2

Connections:
24V2: C25.1, F1.1, R78.1; also elsewhere on the board
+3V3: C35.1, R17.2, U4.2 (VO); also elsewhere on the board
+5V: C6.1, C7.1, C31.1, C33.1, L13.2, R50.2, R52.1, U4.3 (VI); also elsewhere on the board
+24V: C22.1, C23.1, F1.2, J5.1, L12.1
+24VMOT: C18.1, C19.1, C28.1, C124.1, D18.1, F3.1, R49.1, U3.1; also elsewhere on the board
/POWER/BED_MON: C8.1, R78.2, R82.1; also elsewhere on the board
GND: C6.2, C7.2, C8.2, C18.2, C19.2, C20.2, C22.2, C23.2, C25.2, C26.2, C28.2, C31.2, C33.2, C35.2, C124.2, D9.1, D18.2, J6.1, J6.3, J6.5, J6.6, J6.7, J6.8, J6.9, R51.2, R53.2, R82.2, U3.5, U3.7, U3.11, U4.1 (GND); also elsewhere on the board
unnamed: C20.1, U3.4
unnamed: C26.1, F3.2, L12.2
unnamed: C29.1, U3.10
unnamed: C29.2, D19.1, L13.1, U3.9
unnamed: D9.2, R17.1
unnamed: D19.2, R51.1, U3.8
unnamed: J4.1, J6.2, J6.4
unnamed: R49.2, U3.2
unnamed: R50.1, U3.3
unnamed: R52.2, R53.1, U3.6

Notes on the sheet:
power_switch

Schematic: periphrals.sch, Buddy

Parts:
C9, C10, C12, C41, C63: 100n; C_0402_1005Metric
C37: 10u; C_0805_2012Metric
C39: 100n; C_0603_1608Metric
D20, D21, D25, D26, D27, D28, D29, D30, D31, D32, D33, D34, D35, D36: BAV99W; SOT-323_SC-70
J7: 70543-0003; Pin_1x04-XL
J8: 302-S141; IDC-Header_2x07_P2.54mm_Vertical
J9: 70543-0002; Pin_1x03-XL
J10: Conn_02x04_Odd_Even; PinHeader_2x04_P2.54mm_Vertical
L14, L15, L16, L23, L25: BLM18KG121TN1D; R_0603_1608Metric
R18, R22, R23, R41, R42, R57, R63, R69, R70, R89, R90: 100R; R_0402_1005Metric
R54: 10k; R_0402_1005Metric
R55, R56: 1k8; R_0402_1005Metric
R58: 4k7; R_0402_1005Metric
R91: 510R; R_0402_1005Metric
R93: 330R; R_0402_1005Metric

Connections:
+3V3: C37.1, C39.1, D21.2, D34.2, J10.2, J10.6, R58.1; also elsewhere on the board
+5V: C12.1, D20.2, D25.2, D26.2, D27.2, D28.2, D29.2, D30.2, D31.2, D32.2, D33.2, D35.2, D36.2, L15.1, L16.1, L23.1, R54.2; also elsewhere on the board
/CPU/NRST: C41.1, D34.3, R63.2; also elsewhere on the board
/CPU/PA6_THERM-PINDA: C9.2, R55.2; also elsewhere on the board
/CPU/PA8_Z-MIN: C10.1, D20.3, R54.1, R57.2; also elsewhere on the board
/CPU/PB10_SCK2: D30.3, R91.1; also elsewhere on the board
/PERIPHERALS/ESP-GPIO0: J10.3; also elsewhere on the board
/PERIPHERALS/ESP-RST: J10.4; also elsewhere on the board
/PERIPHERALS/ESP-Rx: J10.1; also elsewhere on the board
/PERIPHERALS/ESP-Tx: J10.8; also elsewhere on the board
/PERIPHERALS/FILAMENT_SENSOR: D25.3, R18.2; also elsewhere on the board
/PERIPHERALS/LCD-BUZZER: D36.3, R70.1; also elsewhere on the board
/PERIPHERALS/LCD-CS: D33.3, R42.1; also elsewhere on the board
/PERIPHERALS/LCD-RS: D31.3, R90.1; also elsewhere on the board
/PERIPHERALS/LCD-RST: D32.3, R89.1; also elsewhere on the board
/PERIPHERALS/LCD-SW1: D28.3, R22.2; also elsewhere on the board
/PERIPHERALS/LCD-SW2: D27.3, R23.2; also elsewhere on the board
/PERIPHERALS/LCD-SW3: D26.3, R41.2; also elsewhere on the board
/PERIPHERALS/MISO2: D35.3, R69.1; also elsewhere on the board
/PERIPHERALS/MOSI2: D29.3, R93.1; also elsewhere on the board
GND: C9.1, C10.2, C12.2, C37.2, C39.2, C41.2, C63.2, D20.1, D21.1, D25.1, D26.1, D27.1, D28.1, D29.1, D30.1, D31.1, D32.1, D33.1, D34.1, D35.1, D36.1, J8.11, J8.13, J10.7, L14.1, L25.1; also elsewhere on the board
unnamed: C63.1, J8.1, L16.2
unnamed: D21.3, R55.1, R56.2
unnamed: J7.1, R56.1, R58.2
unnamed: J7.2, R57.1
unnamed: J7.3, L14.2
unnamed: J7.4, L15.2
unnamed: J8.2, R42.2
unnamed: J8.3, R22.1
unnamed: J8.4, R89.2
unnamed: J8.5, R23.1
unnamed: J8.6, R90.2
unnamed: J8.7, R41.1
unnamed: J8.8, R91.2
unnamed: J8.9, R63.1
unnamed: J8.10, R93.2
unnamed: J8.12, R69.2
unnamed: J8.14, R70.2
unnamed: J9.1, L23.2
unnamed: J9.2, R18.1
unnamed: J9.3, L25.2

Notes on the sheet:
LCD
PINDA
FILAMENT SENSOR

Schematic: level_converter.sch, Buddy

Parts:
C13: 100n; C_0402_1005Metric
R59, R60, R61, R62: 1k8; R_0402_1005Metric
U5: AHCT125; Texas_S-PVQFN-N14_ThermalVias

Connections:
+5V: C13.1, U5.14; also elsewhere on the board
/LEVEL_CONVERTER/BED-HEAT: R61.2, U5.12; also elsewhere on the board
/LEVEL_CONVERTER/FAN-0: R62.2, U5.2; also elsewhere on the board
/LEVEL_CONVERTER/FAN-1: R59.2, U5.5; also elsewhere on the board
/LEVEL_CONVERTER/HEAT-0: R60.2, U5.9; also elsewhere on the board
BED-HEAT-5V: U5.11; also elsewhere on the board
FAN-0-5V: U5.3; also elsewhere on the board
FAN-1-5V: U5.6; also elsewhere on the board
GND: C13.2, R59.1, R60.1, R61.1, R62.1, U5.1, U5.4, U5.7, U5.10, U5.13; also elsewhere on the board
HEAT-0-5V: U5.8; also elsewhere on the board

Schematic: trinamic.sch, Buddy

Parts:
C15, C24, C34, C36: 4.7uF; C_0603_1608Metric
C16, C32, C38, C40: 100n; C_0402_1005Metric
C42, C44, C46, C47, C50, C53, C54, C55, C58, C59, C72, C74, C76, C77, C80, C83, C84, C85, C88, C89: 100n; C_0603_1608Metric
C43, C45, C73, C75: 22n; C_0402_1005Metric
C60, C61, C90, C91: 100u; c_elec_6.3x7.7
C64, C65, C66, C67, C68, C69, C70, C71, C94, C95, C96, C97, C98, C99, C100, C101: 1n; C_0603_1608Metric
C92, C93, C121, C122: 10u; C_1206_3216Metric
L31, L32, L33, L34, L35, L36, L37, L38, L39, L40, L41, L42, L43, L44, L45, L46: BLM18KG121TN1D; R_0603_1608Metric
P7, P8, P9, P10: 70543-0003; Pin_1x04-XL
R65, R66, R67, R68, R73, R74, R75, R76: R22; R_1206
U6, U7, U8, U9: TMC2209-LA; QFN-28_EP_5x5_Pitch0.5mm

Connections:
+3V3: C16.2, C32.2, C38.2, C40.2, U6.15, U7.9, U7.15, U8.10, U8.15, U9.9, U9.10, U9.15; also elsewhere on the board
+24VMOT: C42.1, C44.1, C54.1, C55.1, C58.1, C59.1, C60.1, C61.1, C72.1, C74.1, C84.1, C85.1, C88.1, C89.1, C90.1, C91.1, C92.1, C93.1, C121.1, C122.1, U6.22, U6.28, U7.22, U7.28, U8.22, U8.28, U9.22, U9.28; also elsewhere on the board
/CPU/PD0_X-DIR: U7.19; also elsewhere on the board
/CPU/PD1_X-STEP: U7.16; also elsewhere on the board
/CPU/PD2_Z-EN: U6.2; also elsewhere on the board
/CPU/PD3_X-EN: U7.2; also elsewhere on the board
/CPU/PD4_Z-STEP: U6.16; also elsewhere on the board
/CPU/PD12_Y-DIR: U9.19; also elsewhere on the board
/CPU/PD13_Y-STEP: U9.16; also elsewhere on the board
/CPU/PD14_Y-EN: U9.2; also elsewhere on the board
/CPU/PD15_Z-DIR: U6.19; also elsewhere on the board
/CPU/PE1_Y-Diag: U9.11; also elsewhere on the board
/CPU/PE2_X-Diag: U7.11; also elsewhere on the board
/CPU/PE3_Z-Diag: U6.11; also elsewhere on the board
/Trinamic driver/E-DIR: U8.19; also elsewhere on the board
/Trinamic driver/E-Diag: U8.11; also elsewhere on the board
/Trinamic driver/E-EN: U8.2; also elsewhere on the board
/Trinamic driver/E-Step: U8.16; also elsewhere on the board
/Trinamic driver/MOT-UART: U6.14, U7.14, U8.14, U9.14; also elsewhere on the board
GND: C15.1, C16.1, C24.1, C32.1, C34.1, C36.1, C38.1, C40.1, C46.2, C47.2, C50.2, C53.2, C54.2, C55.2, C58.2, C59.2, C60.2, C61.2, C64.1, C65.1, C66.1, C67.1, C68.1, C69.1, C70.1, C71.1, C76.2, C77.2, C80.2, C83.2, C84.2, C85.2, C88.2, C89.2, C90.2, C91.2, C92.2, C93.2, C94.1, C95.1, C96.1, C97.1, C98.1, C99.1, C100.1, C101.1, C121.2, C122.2, R65.1, R66.1, R67.1, R68.1, R73.1, R74.1, R75.1, R76.1, U6.3, U6.9, U6.10, U6.13, U6.18, U6.25, U6.29, U7.3, U7.10, U7.13, U7.18, U7.25, U7.29, U8.3, U8.9, U8.13, U8.18, U8.25, U8.29, U9.3, U9.13, U9.18, U9.25, U9.29; also elsewhere on the board
unnamed: C15.2, U6.8
unnamed: C24.2, U7.8
unnamed: C34.2, U8.8
unnamed: C36.2, U9.8
unnamed: C42.2, U6.6
unnamed: C43.1, U6.4
unnamed: C43.2, U6.5
unnamed: C44.2, U7.6
unnamed: C45.1, U7.4
unnamed: C45.2, U7.5
unnamed: C46.1, R65.2, U6.27
unnamed: C47.1, R66.2, U7.27
unnamed: C50.1, R67.2, U6.23
unnamed: C53.1, R68.2, U7.23
unnamed: C64.2, L37.2, P7.1
unnamed: C65.2, L31.2, P7.2
unnamed: C66.2, L32.2, P7.3
unnamed: C67.2, L33.2, P7.4
unnamed: C68.2, L38.2, P8.1
unnamed: C69.2, L34.2, P8.2
unnamed: C70.2, L35.2, P8.3
unnamed: C71.2, L36.2, P8.4
unnamed: C72.2, U8.6
unnamed: C73.1, U8.4
unnamed: C73.2, U8.5
unnamed: C74.2, U9.6
unnamed: C75.1, U9.4
unnamed: C75.2, U9.5
unnamed: C76.1, R73.2, U8.27
unnamed: C77.1, R74.2, U9.27
unnamed: C80.1, R75.2, U8.23
unnamed: C83.1, R76.2, U9.23
unnamed: C94.2, L45.2, P9.1
unnamed: C95.2, L39.2, P9.2
unnamed: C96.2, L40.2, P9.3
unnamed: C97.2, L41.2, P9.4
unnamed: C98.2, L46.2, P10.1
unnamed: C99.2, L42.2, P10.2
unnamed: C100.2, L43.2, P10.3
unnamed: C101.2, L44.2, P10.4
unnamed: L31.1, U6.26
unnamed: L32.1, U6.24
unnamed: L33.1, U6.21
unnamed: L34.1, U7.26
unnamed: L35.1, U7.24
unnamed: L36.1, U7.21
unnamed: L37.1, U6.1
unnamed: L38.1, U7.1
unnamed: L39.1, U8.26
unnamed: L40.1, U8.24
unnamed: L41.1, U8.21
unnamed: L42.1, U9.26
unnamed: L43.1, U9.24
unnamed: L44.1, U9.21
unnamed: L45.1, U8.1
unnamed: L46.1, U9.1

Schematic: eeprom.sch, Buddy

Parts:
C49: 10p*; C_0402_1005Metric
C52: 100n; C_0402_1005Metric
J11: UFL coaxial; UFL-MOLEX-73412-0114
R28, R29: 1k5; R_0402_1005Metric
U11: ST25DV64K; TSSOP-8_4.4x3mm_P0.65mm

Connections:
+3V3: C52.1, R28.2, R29.2, U11.8 (VCC); also elsewhere on the board
/CPU/PB8_SCL: R28.1, U11.6 (SCL); also elsewhere on the board
/CPU/PB9_SDA: R29.1, U11.5 (SDA); also elsewhere on the board
GND: C52.2, U11.4 (GND); also elsewhere on the board
unnamed: C49.1, J11.2, U11.2 (AC0)
unnamed: C49.2, J11.1, U11.3 (AC1)

Schematic: ethernet.sch, Buddy

Parts:
C17, C56: 30p; C_0402_1005Metric
C48: 10u; C_0805_2012Metric
C57: 470p; C_0402_1005Metric
C78: 1u; C_0603_1608Metric
C79, C102, C103, C119, C120: 100n; C_0402_1005Metric
C81, C82: 10n; C_0402_1005Metric
C86: 100u; C_1206_3216Metric
C123, C126, C127, C128: 10p; C_0402_1005Metric
C129: 10n*; C_0402_1005Metric
J3: HR911105A
L10, L17: BLM18KG121TN1D; R_0603_1608Metric
R24, R25, R27, R32, R98, R99: 33R; R_0402_1005Metric
R26, R33, R34, R35, R84, R96: 10k; R_0402_1005Metric
R30: 1k5; R_0402_1005Metric
R36: 12k1; R_0402_1005Metric
R37, R38, R39, R40: 49.9R; R_0402_1005Metric
R71: 100R*; R_0402_1005Metric
R72, R97: 10k*; R_0402_1005Metric
R94, R95: 620R; R_0603_1608Metric
U1: LAN8742A-CZ-TR; VQFN-24-1EP_4x4mm_P0.5mm_EP2.45x2.45mm_ThermalVias
U13: DT1140-04LP
X1: ASE-xxxMHz*; Oscillator_SMD_EuroQuartz_XO53-4Pin_5.0x3.2mm
Y4: ECS-250-20-30B-AGL-TR; Crystal_SMD_Abracon_ABM3C-4Pin_5.0x3.2mm

Connections:
+3V3: C48.1, C79.1, C129.1, L10.2, R30.1, R33.1, R34.1, R35.1, R72.1, U1.9, X1.4; also elsewhere on the board
/ETHERNET/EPHY_RST: U1.15; also elsewhere on the board
/ETHERNET/ETH_LED1: J3.12, R96.1, U1.3
/ETHERNET/ETH_LED2: J3.9, R84.1, U1.2
/ETHERNET/ETH_RMII_CRS_DV: R27.1; also elsewhere on the board
/ETHERNET/ETH_RMII_MDC: U1.13; also elsewhere on the board
/ETHERNET/ETH_RMII_MDIO: R30.2, U1.12; also elsewhere on the board
/ETHERNET/ETH_RMII_REF_CLK: R32.1; also elsewhere on the board
/ETHERNET/ETH_RMII_RXD0: R24.1; also elsewhere on the board
/ETHERNET/ETH_RMII_RXD1: R25.1; also elsewhere on the board
/ETHERNET/ETH_RMII_TXD0: R98.1; also elsewhere on the board
/ETHERNET/ETH_RMII_TXD1: R99.1; also elsewhere on the board
/ETHERNET/ETH_RMII_TX_EN: U1.16; also elsewhere on the board
/ETHERNET/RD_N: C128.1, J3.6, R37.2, U1.22, U13.2
/ETHERNET/RD_P: C127.1, J3.3, R38.2, U1.23, U13.1
/ETHERNET/TD_N: C126.1, J3.2, R39.2, U1.20, U13.5
/ETHERNET/TD_P: C123.1, J3.1, R40.2, U1.21, U13.4
GND: C17.2, C48.2, C56.2, C57.2, C78.2, C79.2, C81.2, C82.2, C86.2, C102.2, C103.2, C119.2, C120.2, C123.2, C126.2, C127.2, C128.2, C129.2, L17.1, R26.1, R36.2, R84.2, R94.1, R95.2, R96.2, R97.2, U1.25, U13.3, X1.2, Y4.2, Y4.4; also elsewhere on the board
unnamed: C17.1, U1.4, Y4.3
unnamed: C56.1, R71.1, U1.5, Y4.1
unnamed: C57.1, C78.1, U1.6
unnamed: C81.1, C82.1, C86.1, C102.1, C103.1, C119.1, C120.1, J3.4, J3.5, L10.1, R37.1, R38.1, R39.1, R40.1, U1.1, U1.19
unnamed: J3.10, R94.2
unnamed: J3.11, R95.1
unnamed: J3.8, J3.13, L17.2
unnamed: R24.2, R33.2, U1.8
unnamed: R25.2, R34.2, U1.7
unnamed: R26.2, U1.10
unnamed: R27.2, R35.2, U1.11
unnamed: R32.2, R97.1, U1.14
unnamed: R36.1, U1.24
unnamed: R71.2, X1.3
unnamed: R72.2, X1.1
unnamed: R98.2, U1.17
unnamed: R99.2, U1.18

Schematic: usb.sch, Buddy

Parts:
C5: 10u*; C_0805_2012Metric
C21: 4u7; C_0805_2012Metric
C87, C115: 100n; C_0402_1005Metric
D10, D22: USBLC6-2P6; SOT143B
D11: ESDA6V1L; SOT-23
D17: GRN; LED_0603
J2: 105017-0001; USB-micro
J20: 67329-8000; USB-A-vertical-MX-67329-8000
JP1: Jumper; SolderJumper-2_P1.3mm_Open_TrianglePad1.0x1.5mm
L7, L8, L9, L27, L48: BLM18KG121TN1D; R_0603_1608Metric
R19: 1k; R_0603_1608Metric
R20: 2k; R_0603_1608Metric
R21: 1k; R_0402_1005Metric
R87: 47k; R_0402_1005Metric
R88: 620R; R_0603_1608Metric
R92: 0R; R_0402_1005Metric
U12: STMPS2141STR; SOT-23-5

Connections:
+3V3: R87.1, R88.1; also elsewhere on the board
+5V: JP1.2, U12.5; also elsewhere on the board
/CPU/PA9_USB-FS-VBUS: R19.1, R20.2; also elsewhere on the board
/CPU/PA10_USB-FS-ID: R21.1; also elsewhere on the board
/CPU/PE4_USB-HS-OVERCURRENT: R92.2; also elsewhere on the board
/CPU/PE5_USB-HS-PWR-EN: U12.4; also elsewhere on the board
GND: C5.2, C21.2, C87.2, C115.2, D10.1, D11.3, D22.1, J2.5, J20.4, L9.1, L48.1, R19.2, U12.2; also elsewhere on the board
unnamed: C5.1, L7.1, R20.1
unnamed: C21.1, L27.1, U12.1
unnamed: C87.1, D10.4, J2.1, JP1.1, L7.2
unnamed: C115.1, D22.4, J20.1, L27.2
unnamed: D11.2, J2.4, L8.2
unnamed: D17.1, R87.2, R92.1, U12.3
unnamed: D17.2, R88.2
unnamed: J2.6, L9.2
unnamed: J20.5, L48.2
unnamed: L8.1, R21.2
USB-FS_N: D10.3, J2.2; also elsewhere on the board
USB-FS_P: D10.2, J2.3; also elsewhere on the board
USB-HS_N: D22.3, J20.2; also elsewhere on the board
USB-HS_P: D22.2, J20.3; also elsewhere on the board

Schematic: cpu.sch, Buddy

Parts:
C11, C27, C30, C108, C109, C110, C111, C112, C113, C114, C125: 100n; C_0402_1005Metric
C104, C105: 10p; C_0402_1005Metric
C106, C107: 2,2u; C_0603_1608Metric
C116, C118: 10u; C_0603_1608Metric
C117: 1u; C_0603_1608Metric
D24: BAT54KFILM; D_SOD-523
J1: Conn_01x03; PinHeader_1x03_P2.54mm_Vertical
J1-jumper1: 2,54 jumper; MEC
J12, J13, J14, J15: Conn_01x01; Fiducial_1mm_Dia_2.54mm_Outer_CopperTop
J16, J17, J18, J19: Conn_01x01; MountingHole_3.2mm_M3_ISO14580_Pad
J21: Conn_01x05; PinHeader_1x05_P2.54mm_Vertical
J23: Conn_01x10; MOLEX_559321010
L11, L47: BLM18KG121TN1D; R_0603_1608Metric
NT3, NT4: Net-Tie_2; NetTie-2_SMD_Pad0.5mm
R64, R79: 1k; R_0402_1005Metric
R80, R85: 4k7; R_0402_1005Metric
R81: 10k; R_0402_1005Metric
R83: 1k*; R_0402_1005Metric
R86: 0R; R_0402_1005Metric
SW1: TACTA-64N-F; TACT-90
U10: MCU-STM32F407VGT6(LQFP100); LQFP-100_14x14mm_P0.5mm
Y2: Crystal; Crystal-3.2x2.5mm

Connections:
+3V3: C11.1, C27.1, C30.1, C109.1, C110.1, C111.1, C112.1, C118.1, D24.1, J1.1, L11.1, L47.1, R81.2, U10.6, U10.11, U10.19, U10.28, U10.50, U10.75, U10.100; also elsewhere on the board
/CPU/BOOT0: NT3.1, R85.2, U10.94
/CPU/NRST: C125.1, J21.4, R79.2, U10.14; also elsewhere on the board
/CPU/PA4_THERM-1: U10.29; also elsewhere on the board
/CPU/PA5_THERM-2: U10.30; also elsewhere on the board
/CPU/PA6_THERM-PINDA: U10.31; also elsewhere on the board
/CPU/PA8_Z-MIN: U10.67; also elsewhere on the board
/CPU/PA9_USB-FS-VBUS: U10.68; also elsewhere on the board
/CPU/PA10_USB-FS-ID: U10.69; also elsewhere on the board
/CPU/PB5: J23.2, U10.91
/CPU/PB8_SCL: J23.5, U10.95; also elsewhere on the board
/CPU/PB9_SDA: J23.6, U10.96; also elsewhere on the board
/CPU/PB10_SCK2: U10.47; also elsewhere on the board
/CPU/PC0_THERM-0: U10.15; also elsewhere on the board
/CPU/PC10_SCK: U10.78; also elsewhere on the board
/CPU/PD0_X-DIR: U10.81; also elsewhere on the board
/CPU/PD1_X-STEP: U10.82; also elsewhere on the board
/CPU/PD2_Z-EN: U10.83; also elsewhere on the board
/CPU/PD3_X-EN: U10.84; also elsewhere on the board
/CPU/PD4_Z-STEP: U10.85; also elsewhere on the board
/CPU/PD12_Y-DIR: U10.59; also elsewhere on the board
/CPU/PD13_Y-STEP: U10.60; also elsewhere on the board
/CPU/PD14_Y-EN: U10.61; also elsewhere on the board
/CPU/PD15_Z-DIR: U10.62; also elsewhere on the board
/CPU/PE0: J23.1, U10.97
/CPU/PE1_Y-Diag: U10.98; also elsewhere on the board
/CPU/PE2_X-Diag: U10.1; also elsewhere on the board
/CPU/PE3_Z-Diag: U10.2; also elsewhere on the board
/CPU/PE4_USB-HS-OVERCURRENT: U10.3; also elsewhere on the board
/CPU/PE5_USB-HS-PWR-EN: U10.4; also elsewhere on the board
/CPU/RX_1: J23.4, R83.1, U10.93
/CPU/SWCLK: J21.1, U10.76
/CPU/SWDIO: J21.3, NT4.1, U10.72
/CPU/SWO: J21.5, U10.89
/CPU/TX_1: J23.3, R83.2, U10.92
/CPU/VDDA: C113.1, C116.1, L47.2, R86.2, U10.22
/CPU/VREF+: C114.1, C117.1, R86.1, U10.21
/ETHERNET/EPHY_RST: U10.39; also elsewhere on the board
/ETHERNET/ETH_RMII_CRS_DV: U10.32; also elsewhere on the board
/ETHERNET/ETH_RMII_MDC: U10.16; also elsewhere on the board
/ETHERNET/ETH_RMII_MDIO: U10.25; also elsewhere on the board
/ETHERNET/ETH_RMII_REF_CLK: U10.24; also elsewhere on the board
/ETHERNET/ETH_RMII_RXD0: U10.33; also elsewhere on the board
/ETHERNET/ETH_RMII_RXD1: U10.34; also elsewhere on the board
/ETHERNET/ETH_RMII_TXD0: U10.51; also elsewhere on the board
/ETHERNET/ETH_RMII_TXD1: U10.52; also elsewhere on the board
/ETHERNET/ETH_RMII_TX_EN: U10.48; also elsewhere on the board
/FANS/FAN-0-TACH: U10.41; also elsewhere on the board
/FANS/FAN-1-TACH: U10.45; also elsewhere on the board
/FLASH/FLASH-CSN: U10.88; also elsewhere on the board
/FLASH/MISO: U10.79; also elsewhere on the board
/FLASH/MOSI: U10.80; also elsewhere on the board
/LEVEL_CONVERTER/BED-HEAT: U10.35; also elsewhere on the board
/LEVEL_CONVERTER/FAN-0: U10.42; also elsewhere on the board
/LEVEL_CONVERTER/FAN-1: U10.40; also elsewhere on the board
/LEVEL_CONVERTER/HEAT-0: U10.36; also elsewhere on the board
/PERIPHERALS/ESP-GPIO0: U10.5; also elsewhere on the board
/PERIPHERALS/ESP-RST: U10.7; also elsewhere on the board
/PERIPHERALS/ESP-Rx: U10.63; also elsewhere on the board
/PERIPHERALS/ESP-Tx: U10.64; also elsewhere on the board
/PERIPHERALS/FILAMENT_SENSOR: U10.90; also elsewhere on the board
/PERIPHERALS/LCD-BUZZER: U10.23; also elsewhere on the board
/PERIPHERALS/LCD-CS: U10.66; also elsewhere on the board
/PERIPHERALS/LCD-RS: U10.58; also elsewhere on the board
/PERIPHERALS/LCD-RST: U10.65; also elsewhere on the board
/PERIPHERALS/LCD-SW1: U10.43; also elsewhere on the board
/PERIPHERALS/LCD-SW2: U10.46; also elsewhere on the board
/PERIPHERALS/LCD-SW3: U10.44; also elsewhere on the board
/PERIPHERALS/MISO2: U10.17; also elsewhere on the board
/PERIPHERALS/MOSI2: U10.18; also elsewhere on the board
/POWER/BED_MON: U10.26; also elsewhere on the board
/Trinamic driver/E-DIR: U10.55; also elsewhere on the board
/Trinamic driver/E-Diag: U10.77; also elsewhere on the board
/Trinamic driver/E-EN: U10.57; also elsewhere on the board
/Trinamic driver/E-Step: U10.56; also elsewhere on the board
/Trinamic driver/MOT-UART: R64.1, U10.87; also elsewhere on the board
GND: C11.2, C27.2, C30.2, C104.2, C105.2, C106.2, C107.2, C108.2, C109.2, C110.2, C111.2, C112.2, C113.2, C114.2, C116.2, C117.2, C118.2, C125.2, J1.3, J16.1, J17.1, J18.1, J19.1, J21.2, J23.9, J23.10, NT3.2, NT4.2, R80.1, SW1.2, U10.10, U10.20, U10.27, U10.74, U10.99, Y2.2, Y2.4; also elsewhere on the board
unnamed: C104.1, U10.13, Y2.1
unnamed: C105.1, U10.12, Y2.3
unnamed: C106.1, U10.49
unnamed: C107.1, U10.73
unnamed: C108.1, D24.2, R79.1, R81.1, SW1.1
unnamed: J1.2, R85.1
unnamed: J23.7, J23.8, L11.2
unnamed: R64.2, U10.86
unnamed: R80.2, U10.37
USB-FS_N: U10.70; also elsewhere on the board
USB-FS_P: U10.71; also elsewhere on the board
USB-HS_N: U10.53; also elsewhere on the board
USB-HS_P: U10.54; also elsewhere on the board

Schematic: flash.sch, Buddy

Parts:
C14: 100n; C_0603_1608Metric
U2: W25Q64JVSSIQ; SOIC8-wide

Connections:
+3V3: C14.1, U2.3, U2.7, U2.8; also elsewhere on the board
/CPU/PC10_SCK: U2.6; also elsewhere on the board
/FLASH/FLASH-CSN: U2.1; also elsewhere on the board
/FLASH/MISO: U2.2; also elsewhere on the board
/FLASH/MOSI: U2.5; also elsewhere on the board
GND: C14.2, U2.4; also elsewhere on the board

Schematic: mosfets.sch, Buddy

Parts:
D12, D14: SK310A-TP; DO-214AC
D13, D15: GRN; LED_0603
P5, P6: TBG-5-PW-2P/GN; PhoenixContact_MSTBVA-G_02x5.08mm_Vertical
Q3, Q4: PSMN2R6-40YS; SOT-669_LFPAK_alternate-numbers_VIA
R43, R46: 100k; R_0402_1005Metric
R44, R47: 100R; R_0402_1005Metric
R45, R48: 10k; R_0603_1608Metric

Connections:
24V2: D12.1, D14.1, P5.2, P6.2, R45.2, R48.2; also elsewhere on the board
BED-HEAT-5V: R46.1, R47.1; also elsewhere on the board
GND: Q3.2 (S), Q4.2 (S), R43.2, R46.2; also elsewhere on the board
HEAT-0-5V: R43.1, R44.1; also elsewhere on the board
unnamed: D12.2, D13.1, P5.1, Q3.3 (D)
unnamed: D13.2, R45.1
unnamed: D14.2, D15.1, P6.1, Q4.3 (D)
unnamed: D15.2, R48.1
unnamed: Q3.1 (G), R44.2
unnamed: Q4.1 (G), R47.2

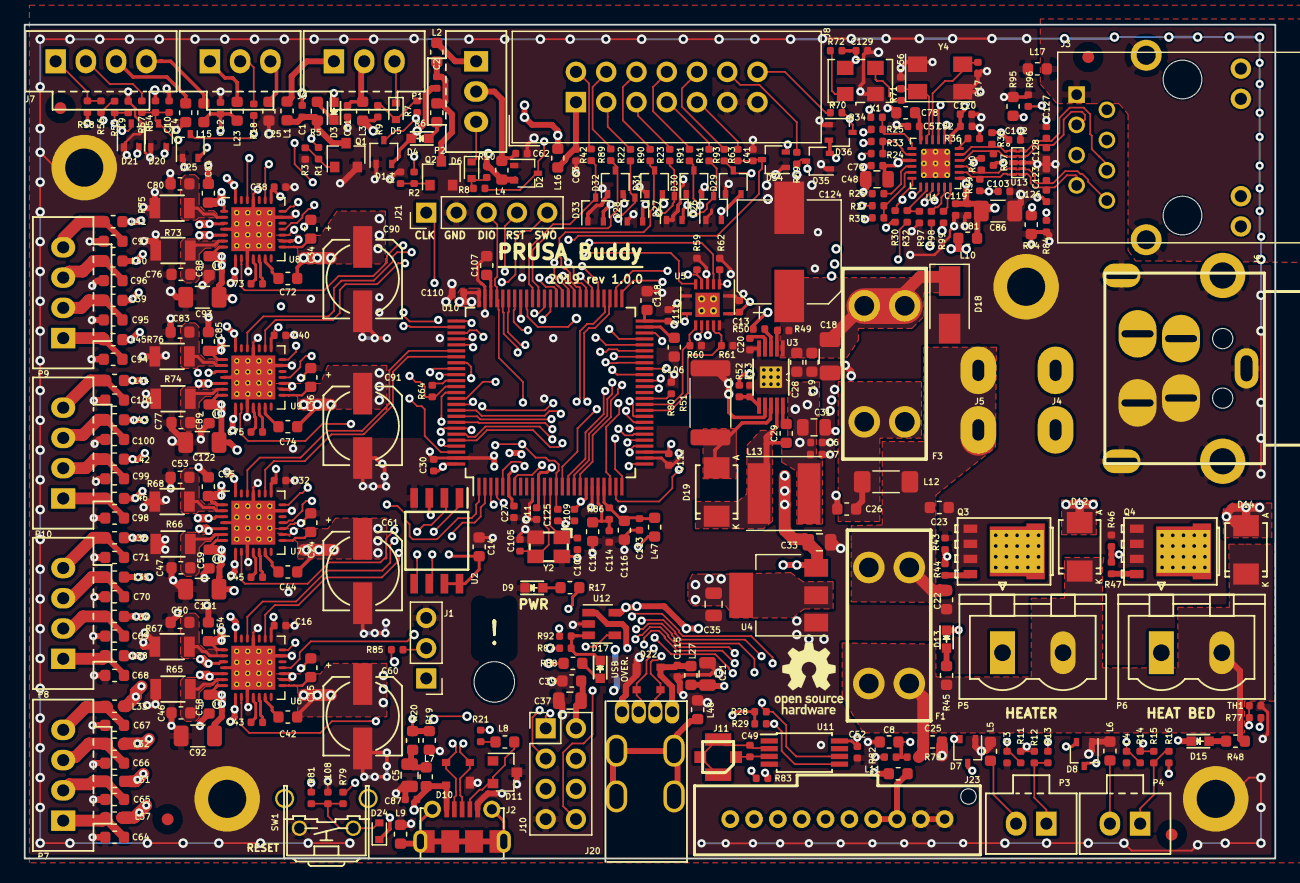
[picture p26: board BUDDY_v1.0.0.kicad_pcb from above]

Board: 6 copper layers, 105.0 x 70.0 mm, 362 parts (1 on the bottom side), 245 nets.

Other parts of the board:
apendix: apendix-1
